bachirstudies-lang/Keep_Tracking/shema electrique/keeptracker_schematic.png

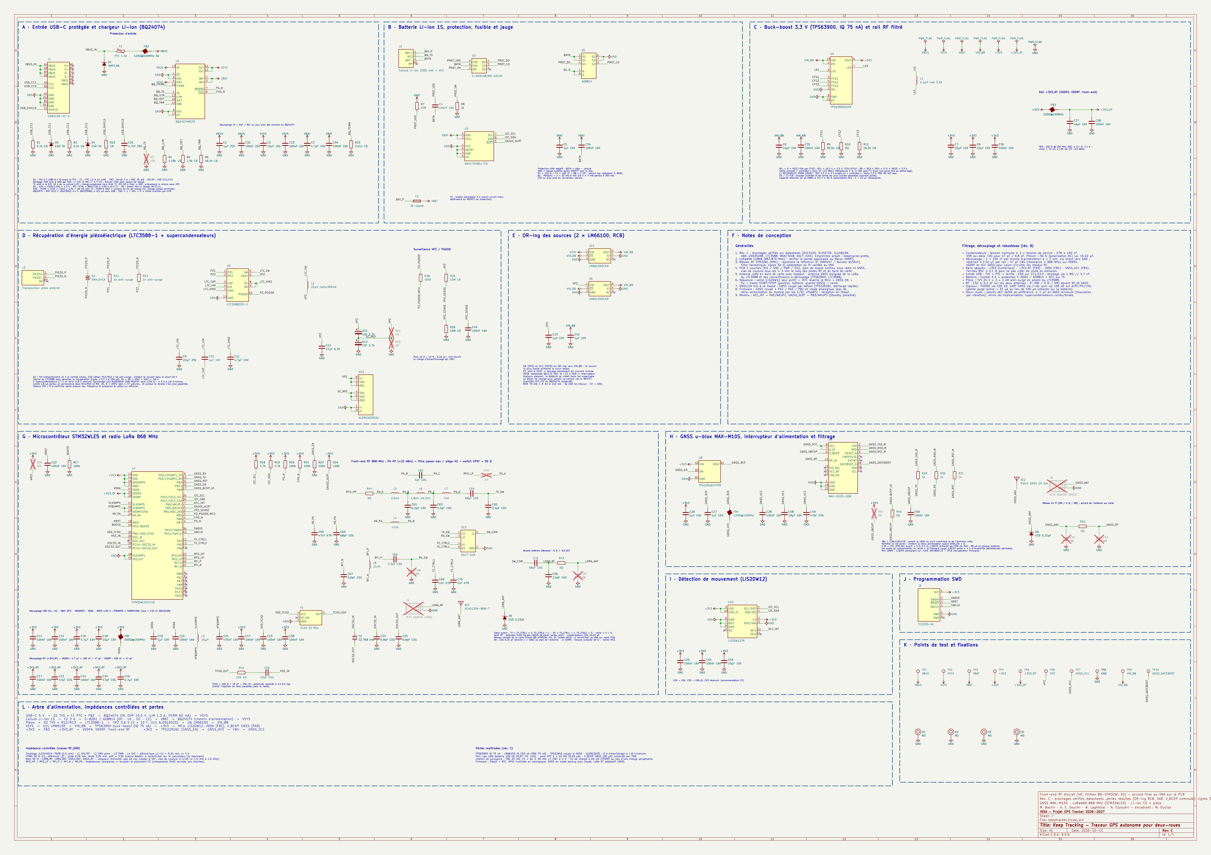
shema electrique/keeptracker_schematic.png
