bachirstudies-lang/Keep_Tracking/shema electrique/rev_B/keeptracker_schematic.png

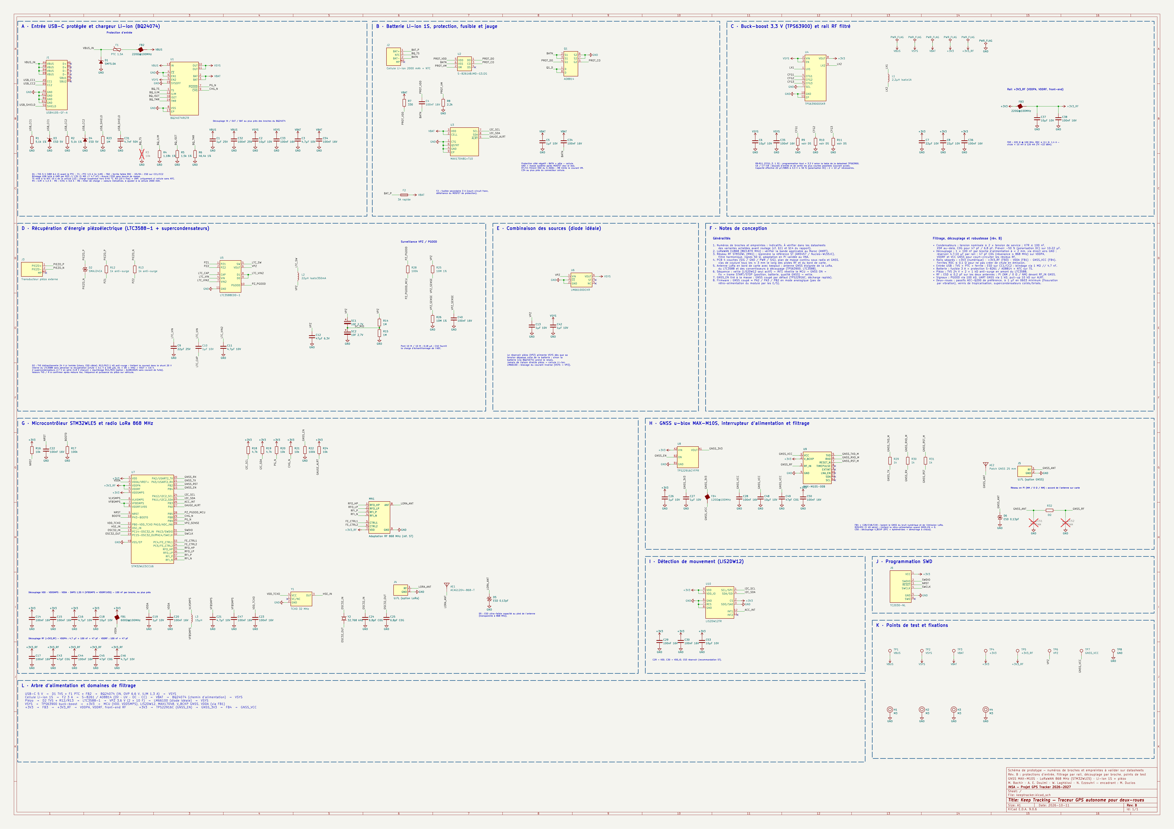
shema electrique/rev_B/keeptracker_schematic.png
