bachirstudies-lang/Keep_Tracking/shema electrique/rev_B/keeptracker_bom.csv

Reference | Value | Footprint | MPN | QUANTITY | DNP
AE1 | ACAG1204-868-T |  |  | 1
AE2 | Patch GNSS 25 mm |  |  | 1
C1 | 1µF 25V | Capacitor_SMD:C_0603_1608Metric |  | 1
C2,C6,C18,C37,C48,C53 | 10µF 10V | Capacitor_SMD:C_0805_2012Metric |  | 6
C3,C11,C16,C21,C46 | 4,7µF 10V | Capacitor_SMD:C_0603_1608Metric |  | 5
C4,C14,C15,C17,C20,C22,C23,C28-C30,C33-C36,C38,C40,C44,C47,C50,C54 | 100nF 16V | Capacitor_SMD:C_0402_1005Metric |  | 20
C5,C13,C19,C26,C27,C42 | 1µF 10V | Capacitor_SMD:C_0402_1005Metric |  | 6
C7,C8 | 22µF 10V | Capacitor_SMD:C_0805_2012Metric |  | 2
C9 | 22µF 25V | Capacitor_SMD:C_1206_3216Metric |  | 1
C10 | 1µF 10V | Capacitor_SMD:C_0603_1608Metric |  | 1
C12 | 47µF 6,3V | Capacitor_SMD:C_1206_3216Metric |  | 1
C24,C25 | 6,8pF C0G | Capacitor_SMD:C_0402_1005Metric |  | 2
C31 | 4,7nF 50V | Capacitor_SMD:C_0402_1005Metric |  | 1
C32 | 100nF 25V | Capacitor_SMD:C_0402_1005Metric |  | 1
C43,C45,C49 | 47pF C0G | Capacitor_SMD:C_0402_1005Metric |  | 3
C51,C52 | NM |  |  | 2 | DNP
D1 | SMF5.0A | Diode_SMD:D_SOD-123F | Littelfuse SMF5.0A | 1
D2 | SMAJ24CA | Diode_SMD:D_SMA | Littelfuse SMAJ24CA | 1
D3,D4 | ESD 5V | Diode_SMD:D_SOD-923 | onsemi ESD9B5.0ST5G | 2
D5,D6 | ESD 0,13pF | Diode_SMD:D_0402_1005Metric | TI TPD1E0B04DPLR | 2
F1 | PTC 1,5A | Fuse:Fuse_1206_3216Metric | Bourns MF-MSMF150-2 | 1
F2 | 3A rapide | Fuse:Fuse_0603_1608Metric | Littelfuse 0467003.NR | 1
FB1 | 600Ω@100MHz | Inductor_SMD:L_0603_1608Metric | Murata BLM18KG601SN1D | 1
FB2,FB3 | 220Ω@100MHz | Inductor_SMD:L_0603_1608Metric | Murata BLM18PG221SN1D | 2
FB4 | 120Ω@100MHz | Inductor_SMD:L_0402_1005Metric | Murata BLM15PX121SN1D | 1
H1-H4 | M3 | MountingHole:MountingHole_3.2mm_M3_Pad_Via |  | 4
J1 | USB4105-GF-A | Connector_USB:USB_C_Receptacle_GCT_USB4105-xx-A_16P_TopMnt_Horizontal | GCT USB4105-GF-A | 1
J2 | Cellule Li-ion 2000 mAh + NTC | Connector_JST:JST_PH_S3B-PH-SM4-TB_1x03-1MP_P2.00mm_Horizontal | JST S3B-PH-SM4-TB | 1
J3 | Transducteur piézo externe | Connector_JST:JST_ZH_B2B-ZR-SM4-TF_1x02-1MP_P1.50mm_Vertical | JST B2B-ZR-SM4-TF | 1
J4 | U.FL (option LoRa) | Connector_Coaxial:U.FL_Hirose_U.FL-R-SMT-1_Vertical |  | 1
J5 | U.FL (option GNSS) | Connector_Coaxial:U.FL_Hirose_U.FL-R-SMT-1_Vertical |  | 1
J6 | TC2030-NL | Connector:Tag-Connect_TC2030-IDC-NL_2x03_P1.27mm_Vertical |  | 1
L1 | 2,2µH Isat≥1A | Inductor_SMD:L_1210_3225Metric | Murata DFE252012F-2R2M | 1
L2 | 22µH Isat≥350mA | Inductor_SMD:L_1210_3225Metric | Murata LQH32PH220MN0 | 1
L3 | 15µH | Inductor_SMD:L_0805_2012Metric | Murata LQM21PN150MC0 | 1
MN1 | Adaptation RF 868 MHz (réf. ST) |  |  | 1
Q1 | AO8814 | Package_SO:TSSOP-8_4.4x3mm_P0.65mm | AOS AO8814 | 1
R1,R2 | 5,1k 1% | Resistor_SMD:R_0603_1608Metric |  | 2
R3 | 10k | Resistor_SMD:R_0603_1608Metric |  | 1 | DNP
R4 | 1,18k 1% | Resistor_SMD:R_0603_1608Metric |  | 1
R5 | 1,5k 1% | Resistor_SMD:R_0603_1608Metric |  | 1
R6 | 46,4k 1% | Resistor_SMD:R_0603_1608Metric |  | 1
R7 | 330 | Resistor_SMD:R_0603_1608Metric |  | 1
R8 | 2,2k | Resistor_SMD:R_0603_1608Metric |  | 1
R9-R11 | voir DS | Resistor_SMD:R_0402_1005Metric |  | 3
R12,R13 | 1k anti-surge | Resistor_SMD:R_1206_3216Metric | Panasonic ERJ-P08J102V | 2
R14,R15,R23 | 1M | Resistor_SMD:R_0603_1608Metric |  | 3
R16,R20,R21,R24 | 10k | Resistor_SMD:R_0603_1608Metric |  | 4
R17,R22,R28 | 100k | Resistor_SMD:R_0603_1608Metric |  | 3
R18,R19 | 4,7k | Resistor_SMD:R_0603_1608Metric |  | 2
R25,R26 | 10M 1% | Resistor_SMD:R_0603_1608Metric |  | 2
R29-R31 | 1k | Resistor_SMD:R_0402_1005Metric |  | 3
R32 | 0Ω | Resistor_SMD:R_0402_1005Metric |  | 1
SC1,SC2 | 10F 2,7V | Capacitor_THT:CP_Radial_D8.0mm_P3.50mm | Eaton HV0830-2R7106-R | 2
TP1 | VBUS | TestPoint:TestPoint_Pad_D1.5mm |  | 1
TP2 | VSYS | TestPoint:TestPoint_Pad_D1.5mm |  | 1
TP3 | VBAT | TestPoint:TestPoint_Pad_D1.5mm |  | 1
TP4 | +3V3 | TestPoint:TestPoint_Pad_D1.5mm |  | 1
TP5 | +3V3_RF | TestPoint:TestPoint_Pad_D1.5mm |  | 1
TP6 | VPZ | TestPoint:TestPoint_Pad_D1.5mm |  | 1
TP7 | GNSS_VCC | TestPoint:TestPoint_Pad_D1.5mm |  | 1
TP8 | GND | TestPoint:TestPoint_Pad_D1.5mm |  | 1
U1 | BQ24074RGTR | Package_DFN_QFN:VQFN-16-1EP_3x3mm_P0.5mm_EP1.68x1.68mm | TI BQ24074RGTR | 1
U2 | S-8261ABJMD-G3J2G | Package_TO_SOT_SMD:SOT-23-6 | ABLIC S-8261ABJMD-G3J2G | 1
U3 | MAX17048G+T10 | Package_DFN_QFN:TDFN-8-1EP_2x2mm_P0.5mm_EP0.8x1.2mm | Maxim MAX17048G+T10 | 1
U4 | TPS63900DSKR | Package_SON:WSON-10-1EP_2.5x2.5mm_P0.5mm_EP1.2x2mm | TI TPS63900DSKR | 1
U5 | LTC3588EDD-1 | Package_DFN_QFN:DFN-10-1EP_3x3mm_P0.5mm_EP1.65x2.38mm | ADI LTC3588EDD-1 | 1
U6 | LM66100DCKR | Package_TO_SOT_SMD:SOT-363_SC-70-6 | TI LM66100DCKR | 1
U7 | STM32WLE5CCU6 | Package_DFN_QFN:QFN-48-1EP_7x7mm_P0.5mm_EP5.3x5.3mm | ST STM32WLE5CCU6 | 1
U8 | TPS22916CYFPR |  | TI TPS22916CYFPR | 1
U9 | MAX-M10S-00B | RF_GPS:ublox_MAX | u-blox MAX-M10S-00B | 1
U10 | LIS2DW12TR | Package_LGA:LGA-12_2x2mm_P0.5mm | ST LIS2DW12TR | 1
Y1 | TCXO 32 MHz | Oscillator:Oscillator_SMD_SiT_PQFN-4Pin_2.0x1.6mm |  | 1
Y2 | 32,768 kHz | Crystal:Crystal_SMD_3215-2Pin_3.2x1.5mm |  | 1
