bachirstudies-lang/Keep_Tracking/shema electrique/keeptracker.kicad_sch

## KiCad design shema electrique/keeptracker.kicad_sch (2026-10-11)

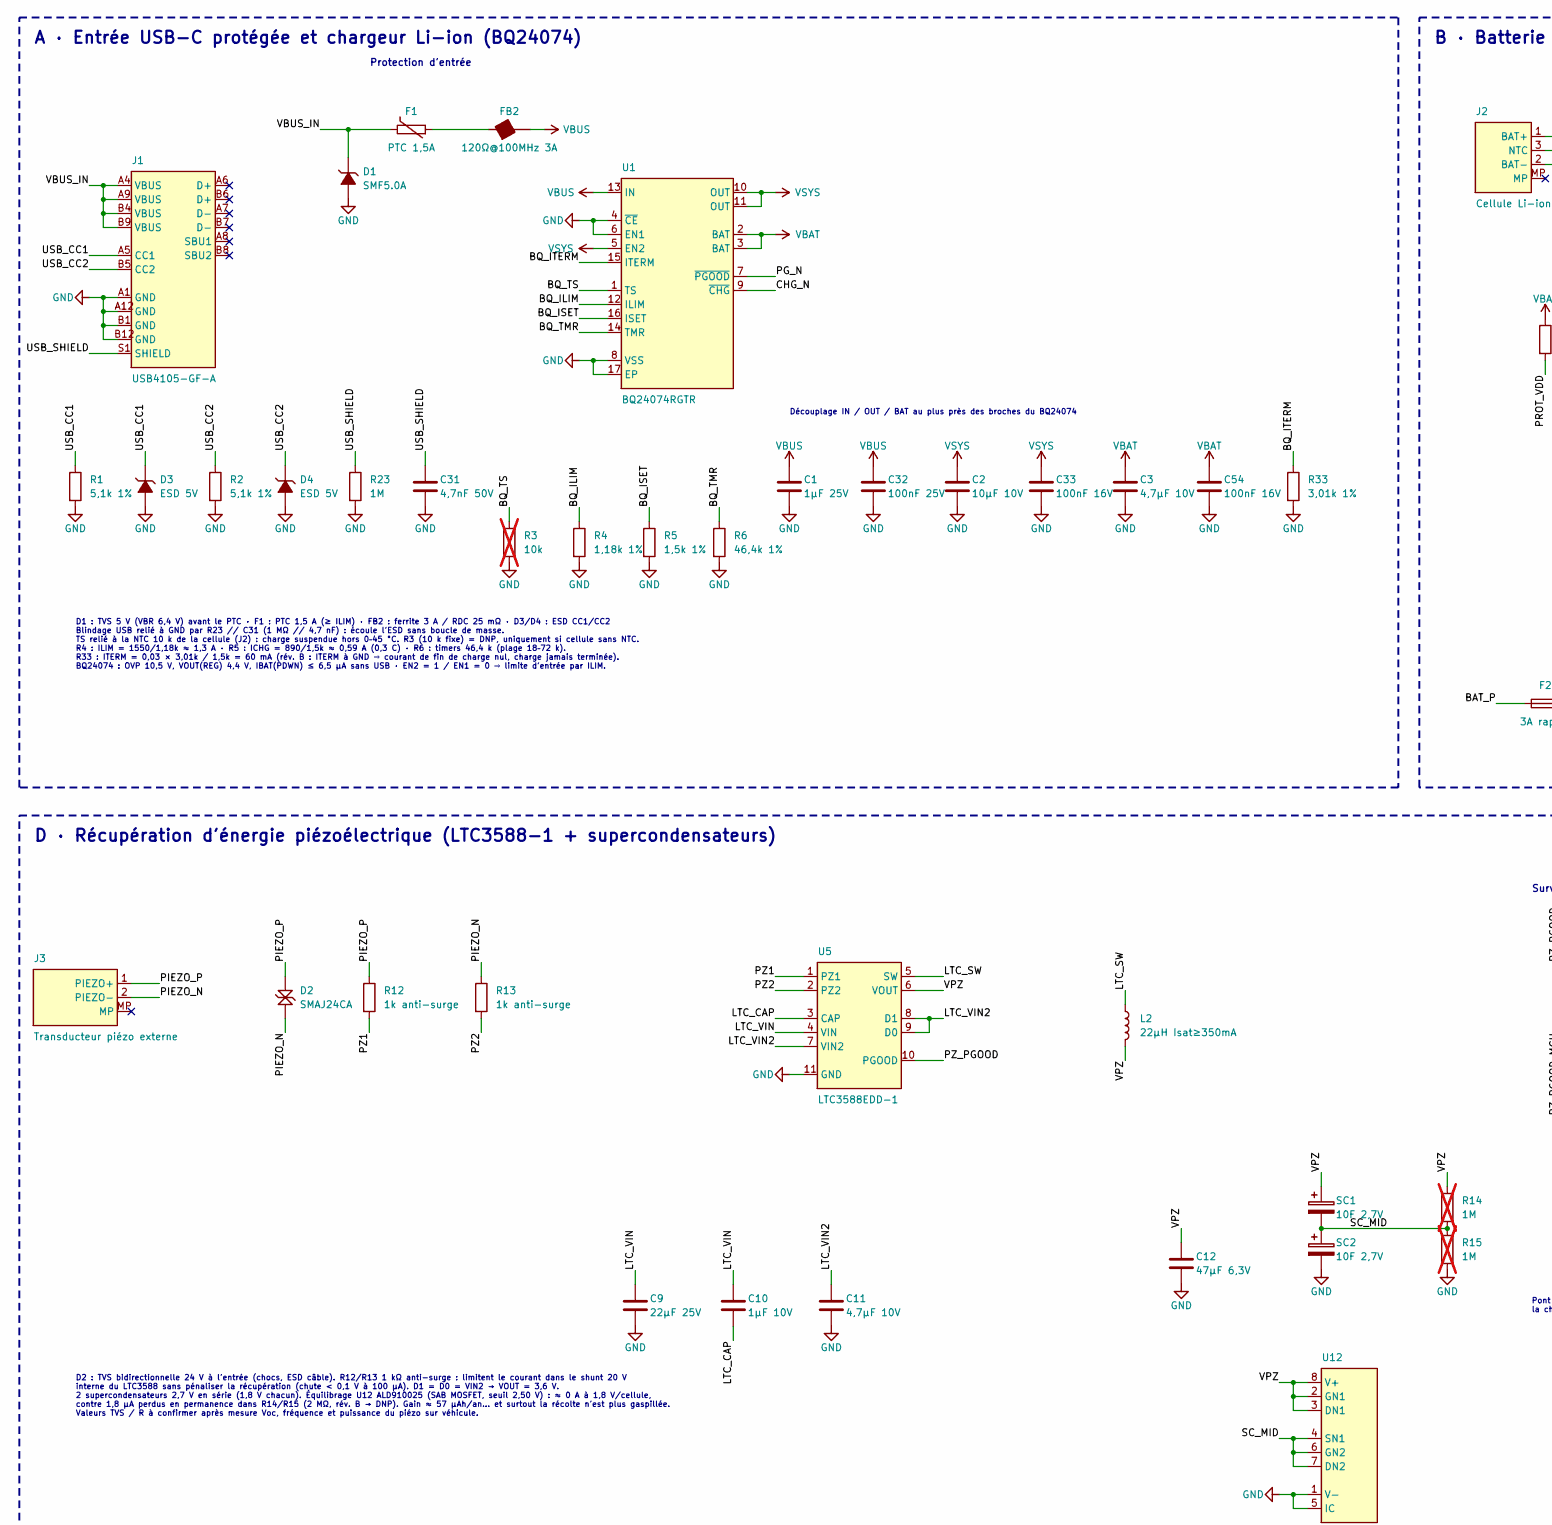
[picture p17: schematic keeptracker.kicad_sch, part in row 1, column 1]

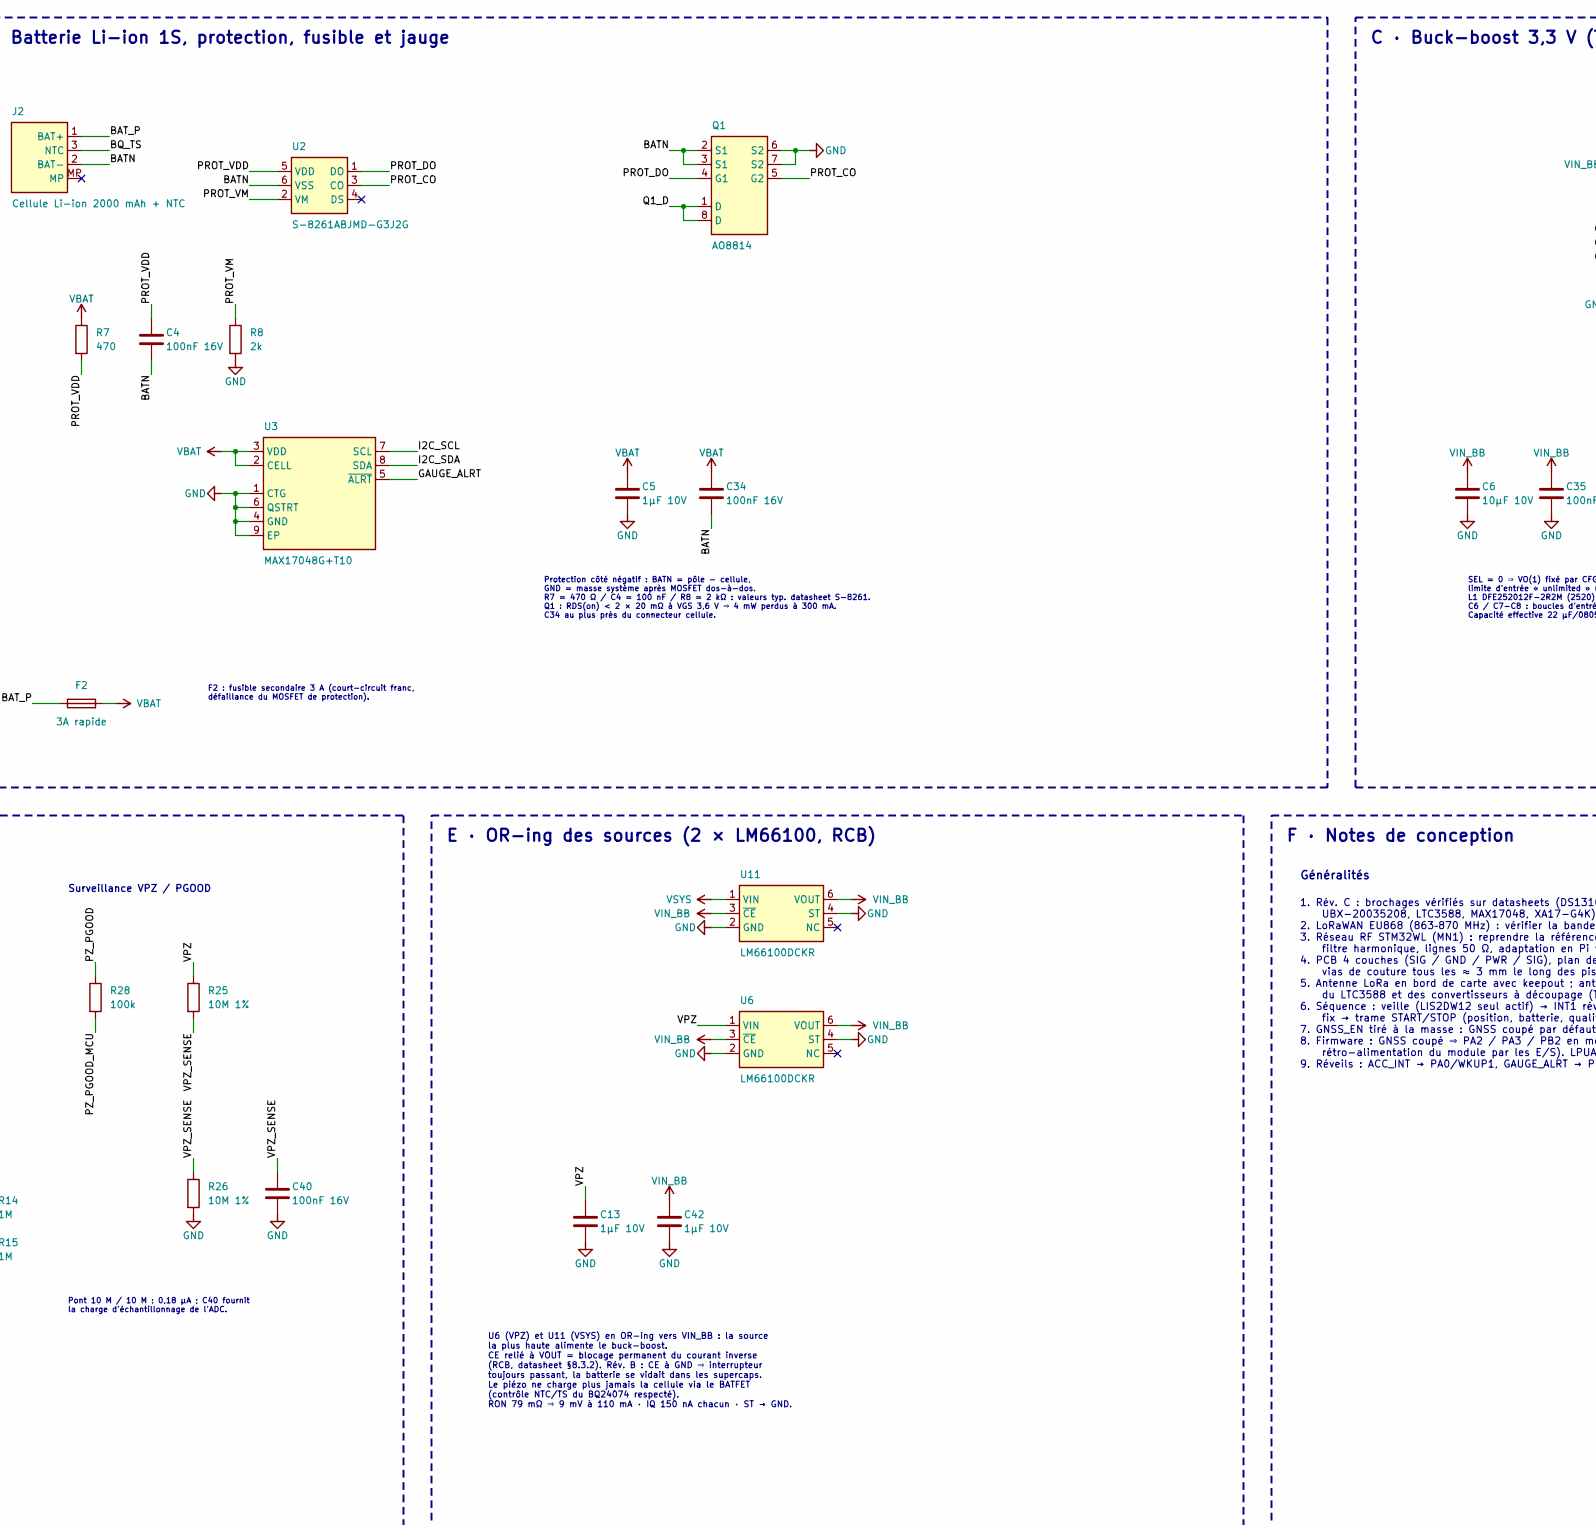
[picture p18: schematic keeptracker.kicad_sch, part in row 1, column 2]

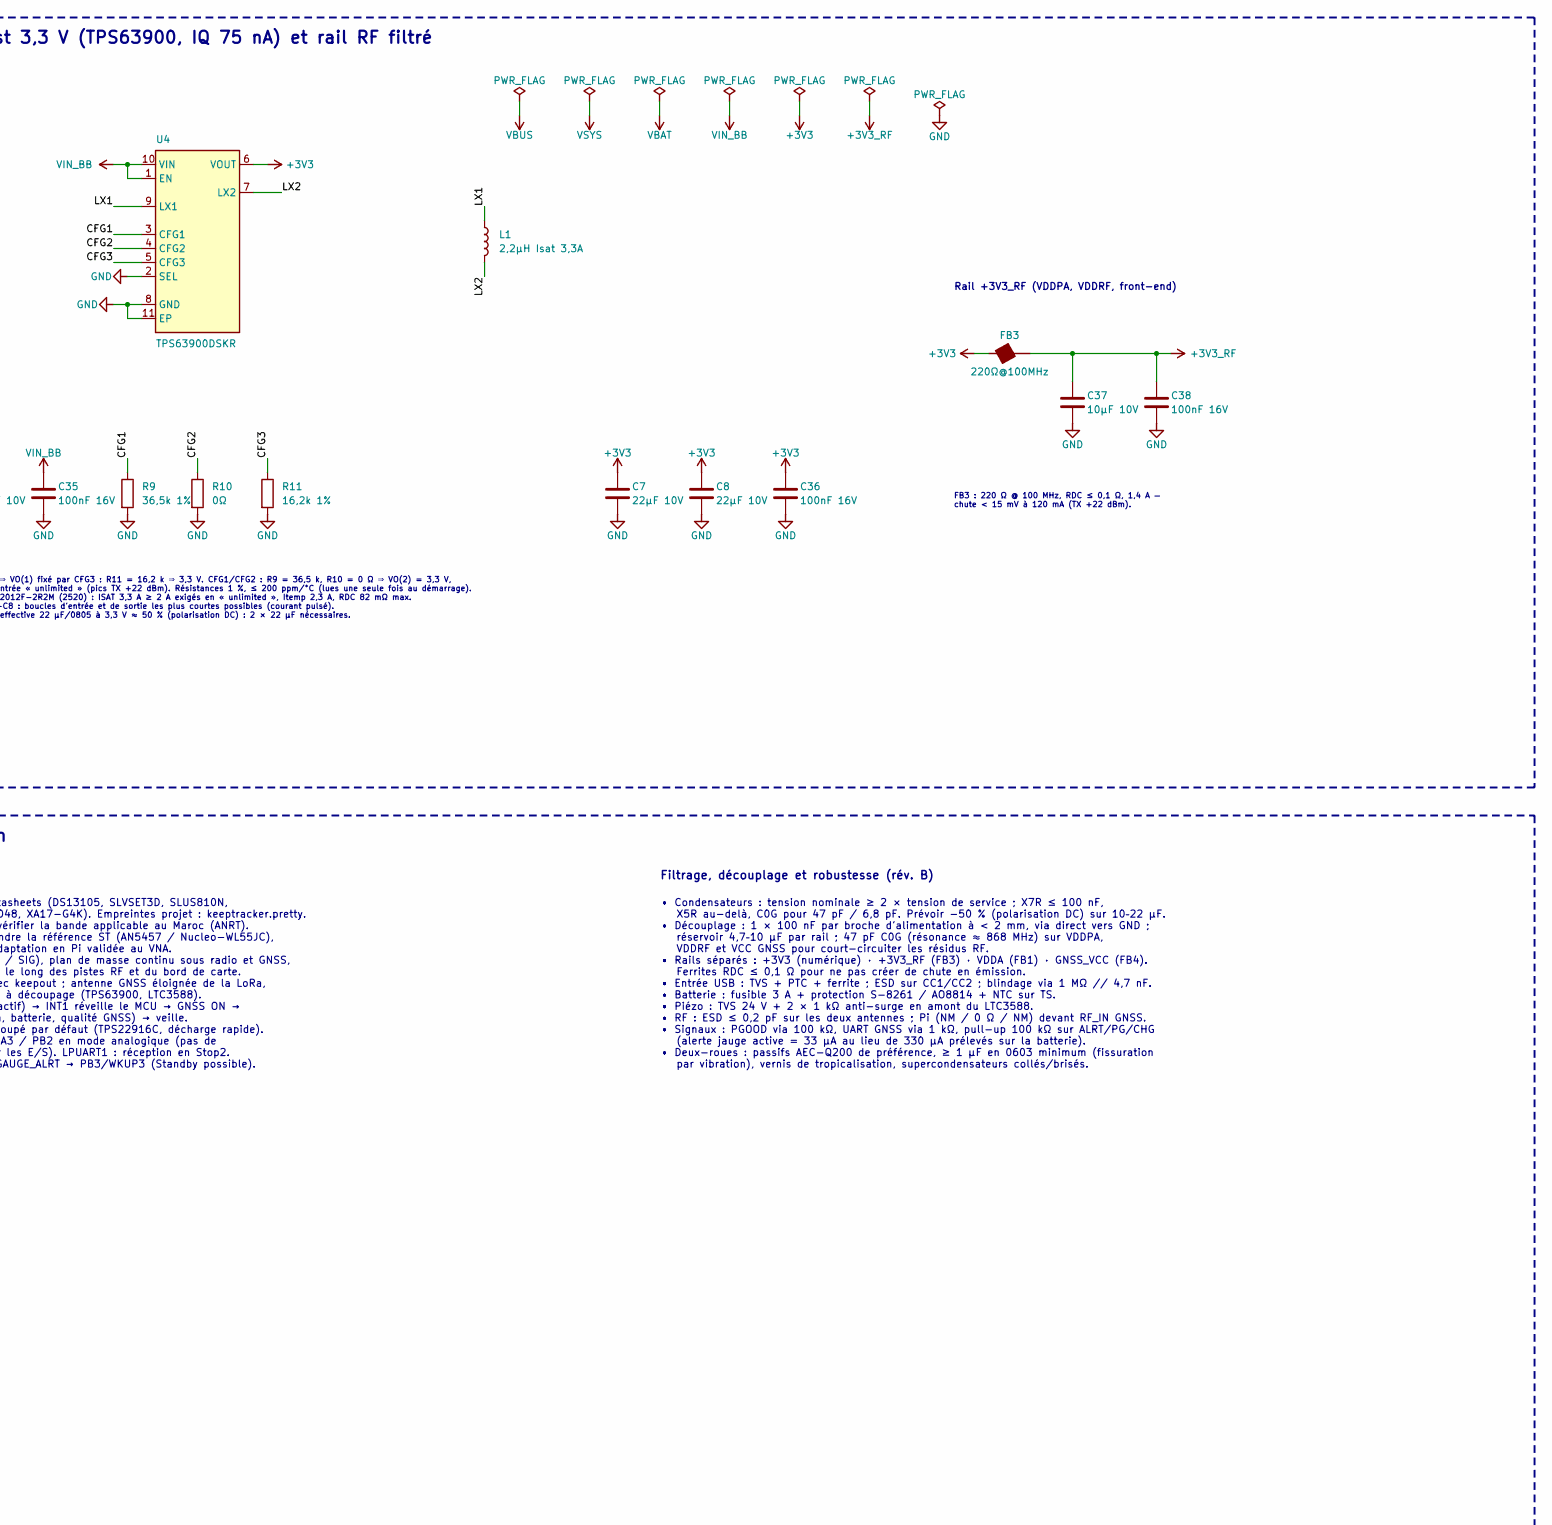
[picture p19: schematic keeptracker.kicad_sch, part in row 1, column 3]

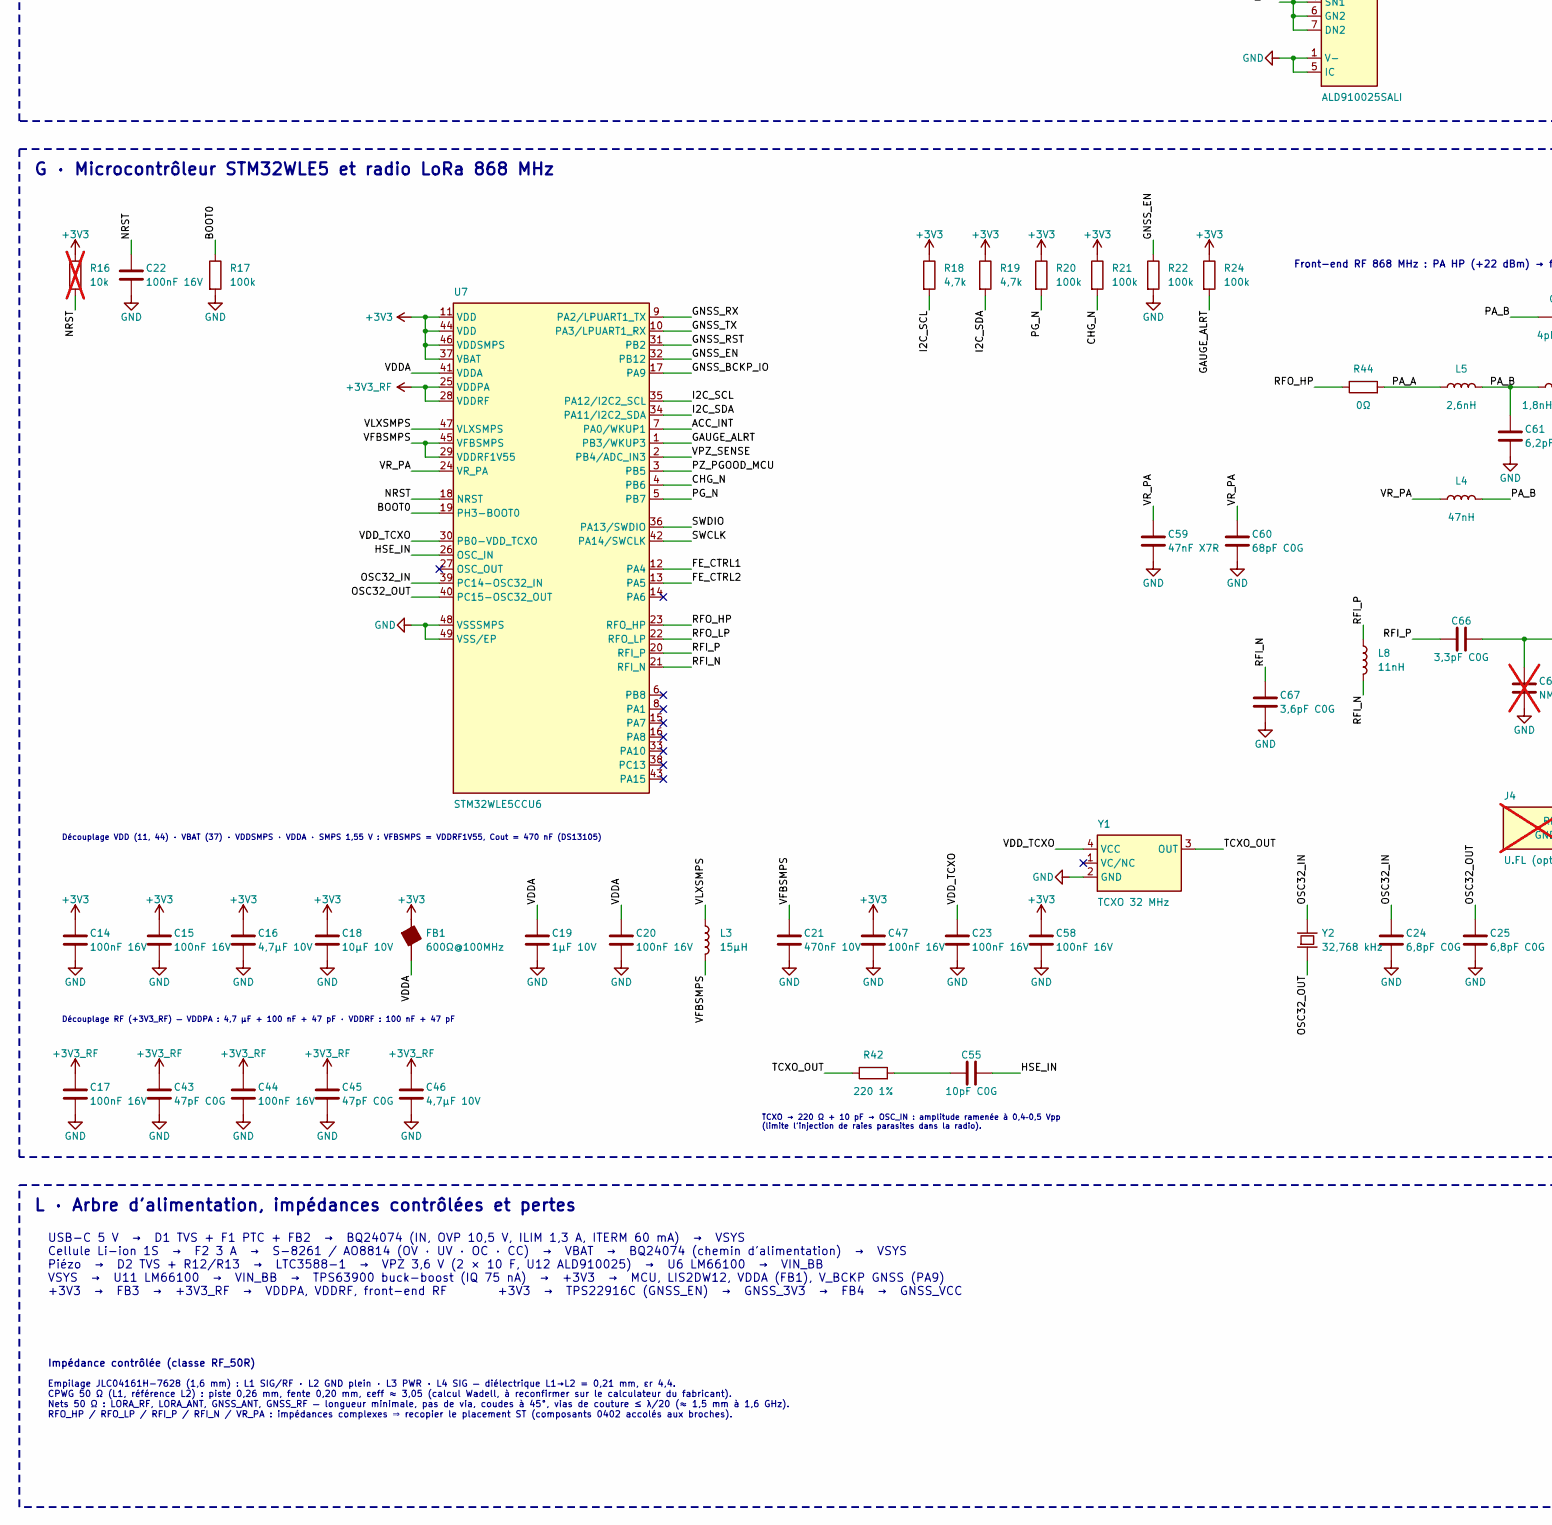
[picture p20: schematic keeptracker.kicad_sch, part in row 2, column 1]

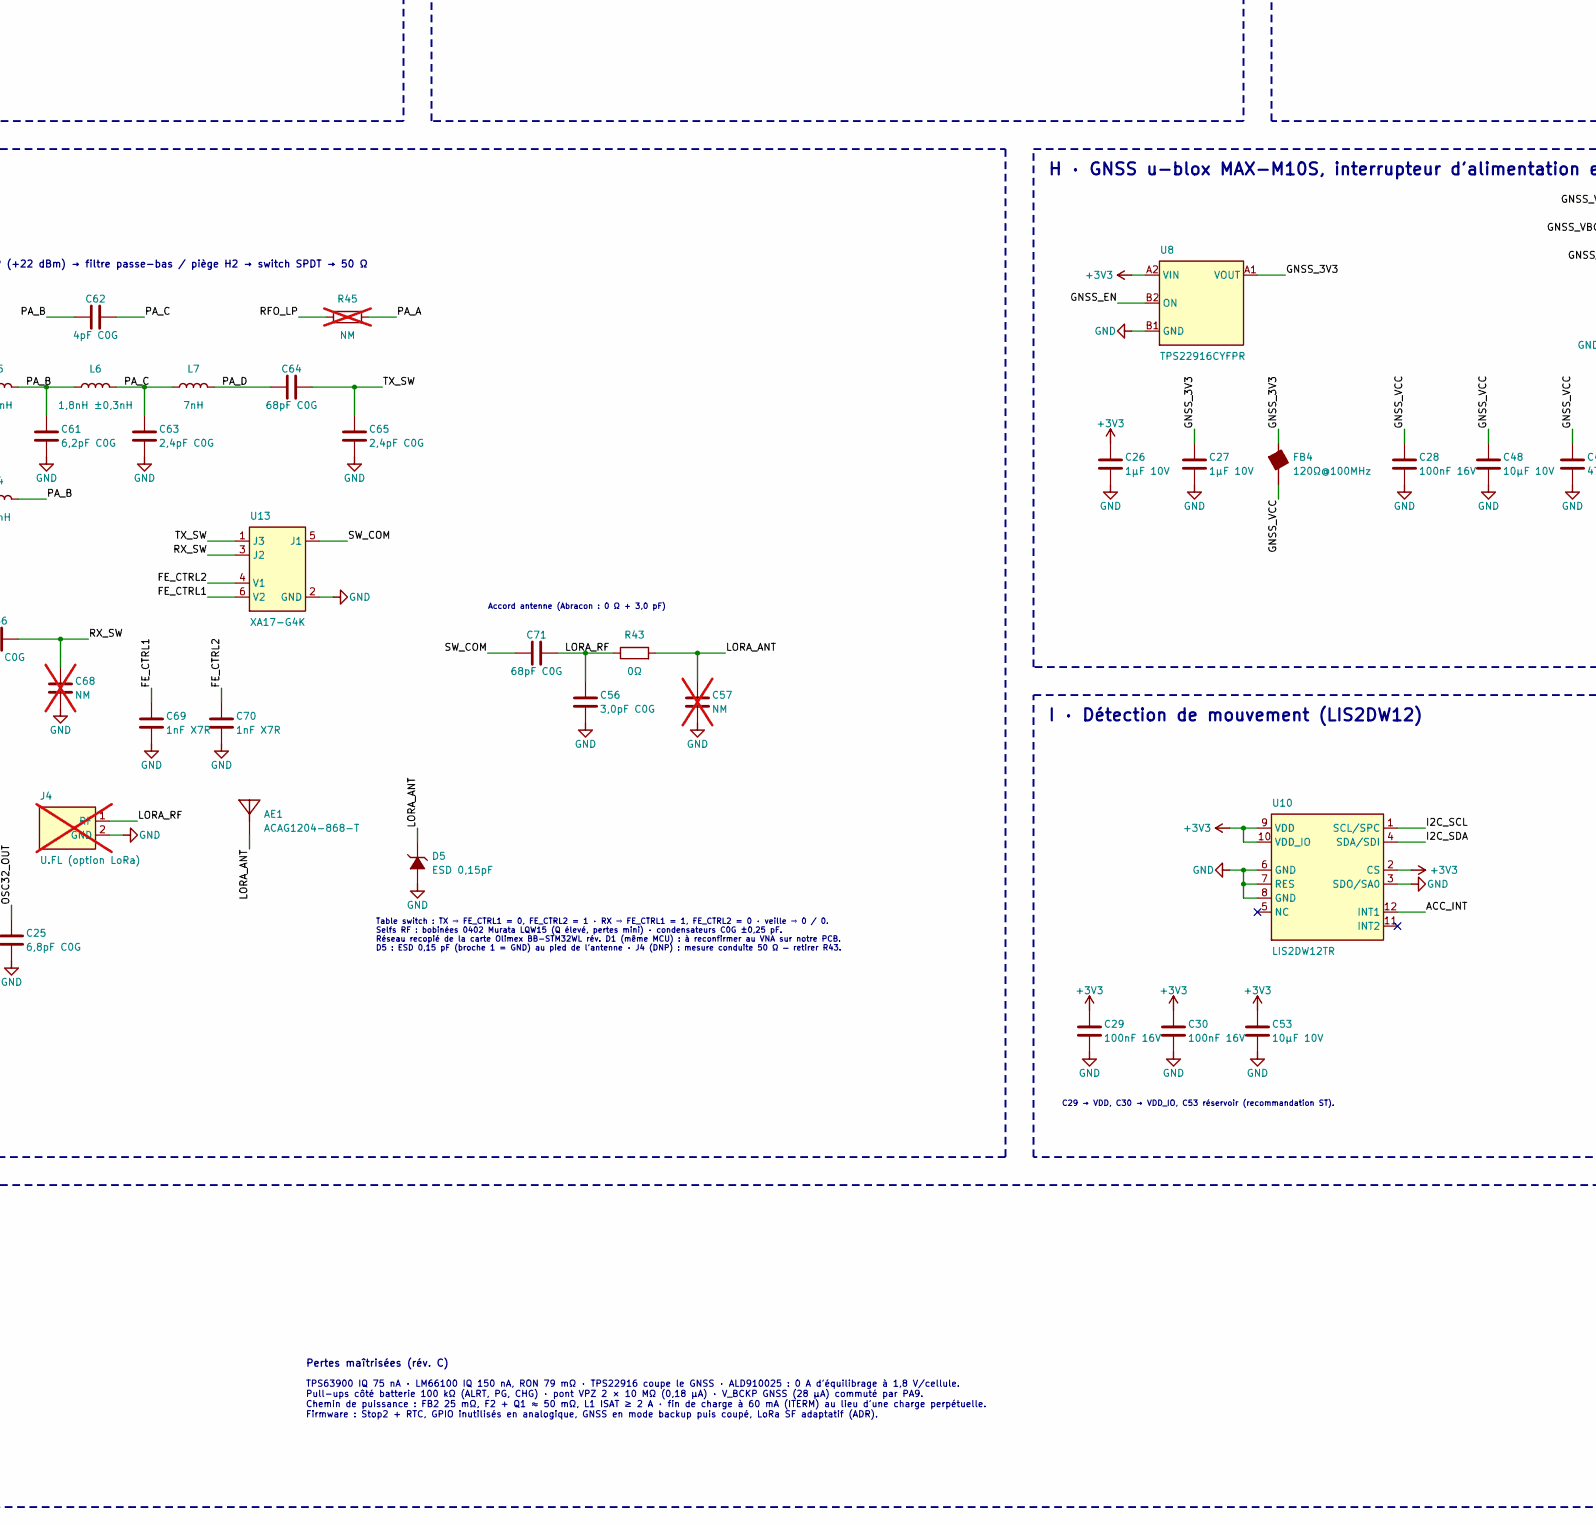
[picture p21: schematic keeptracker.kicad_sch, part in row 2, column 2]

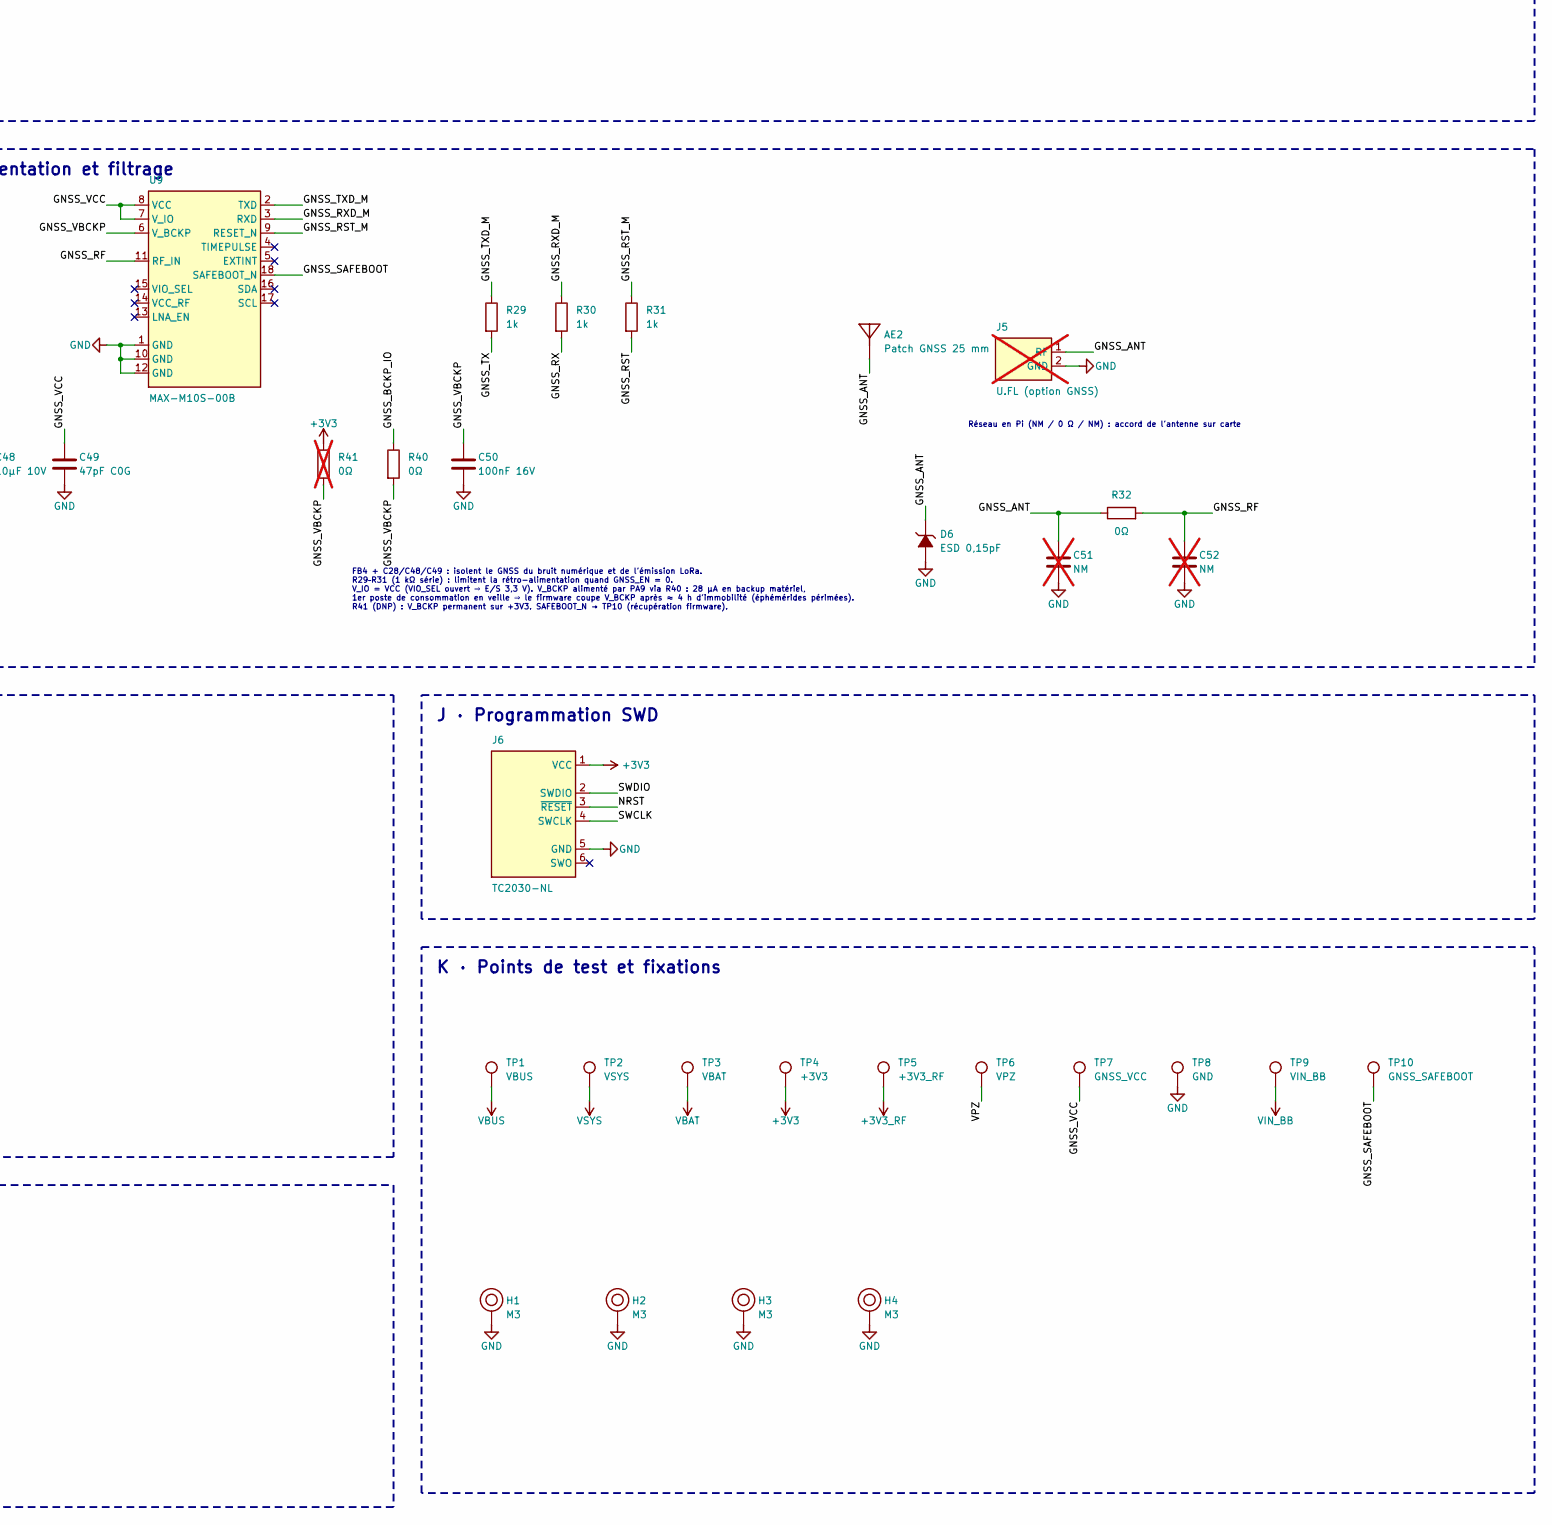
[picture p22: schematic keeptracker.kicad_sch, part in row 2, column 3]

Parts:
AE1: ACAG1204-868-T; Abracon_ACAG1204-868-T; MPN Abracon ACAG1204-868-T
AE2: Patch GNSS 25 mm
C1: 1µF 25V; C_0603_1608Metric
C2, C6, C18, C37, C48, C53: 10µF 10V; C_0805_2012Metric
C3, C11, C16, C46: 4,7µF 10V; C_0603_1608Metric
C4, C14, C15, C17, C20, C22, C23, C28, C29, C30, C33, C34, C35, C36, C38, C40, C44, C47, C50, C54, C58: 100nF 16V; C_0402_1005Metric
C5, C13, C19, C26, C27, C42: 1µF 10V; C_0402_1005Metric
C7, C8: 22µF 10V; C_0805_2012Metric
C9: 22µF 25V; C_1206_3216Metric
C10: 1µF 10V; C_0603_1608Metric
C12: 47µF 6,3V; C_1206_3216Metric
C21: 470nF 10V; C_0402_1005Metric
C24, C25: 6,8pF C0G; C_0402_1005Metric
C31: 4,7nF 50V; C_0402_1005Metric
C32: 100nF 25V; C_0402_1005Metric
C43, C45, C49: 47pF C0G; C_0402_1005Metric
C51, C52, C57: NM; not fitted
C55: 10pF C0G; C_0402_1005Metric
C56: 3,0pF C0G; C_0402_1005Metric; MPN Murata GJM1555C1H3R0CB01
C59: 47nF X7R; C_0402_1005Metric
C60, C64, C71: 68pF C0G; C_0402_1005Metric; MPN Murata GRM1555C1H680JA01
C61: 6,2pF C0G; C_0402_1005Metric; MPN Murata GJM1555C1H6R2DB01
C62: 4pF C0G; C_0402_1005Metric; MPN Murata GJM1555C1H4R0CB01
C63, C65: 2,4pF C0G; C_0402_1005Metric; MPN Murata GJM1555C1H2R4CB01
C66: 3,3pF C0G; C_0402_1005Metric; MPN Murata GJM1555C1H3R3CB01
C67: 3,6pF C0G; C_0402_1005Metric; MPN Murata GJM1555C1H3R6CB01
C68: NM; C_0402_1005Metric; not fitted
C69, C70: 1nF X7R; C_0402_1005Metric
D1: SMF5.0A; D_SOD-123F; MPN Littelfuse SMF5.0A
D2: SMAJ24CA; D_SMA; MPN Littelfuse SMAJ24CA
D3, D4: ESD 5V; D_SOD-923; MPN onsemi ESD9B5.0ST5G
D5, D6: ESD 0,15pF; D_0402_1005Metric; MPN TI TPD1E0B04DPYR
F1: PTC 1,5A; Fuse_1206_3216Metric; MPN Bourns MF-MSMF150-2
F2: 3A rapide; Fuse_0603_1608Metric; MPN Littelfuse 0467003.NR
FB1: 600Ω@100MHz; L_0603_1608Metric; MPN Murata BLM18KG601SN1D
FB2: 120Ω@100MHz 3A; L_0603_1608Metric; MPN Murata BLM18SG121TN1D
FB3: 220Ω@100MHz; L_0603_1608Metric; MPN Murata BLM18PG221SN1D
FB4: 120Ω@100MHz; L_0402_1005Metric; MPN Murata BLM15PX121SN1D
H1, H2, H3, H4: M3; MountingHole_3.2mm_M3_Pad_Via
J1: USB4105-GF-A; USB_C_Receptacle_GCT_USB4105-xx-A_16P_TopMnt_Horizontal; MPN GCT USB4105-GF-A
J2: Cellule Li-ion 2000 mAh + NTC; JST_PH_S3B-PH-SM4-TB_1x03-1MP_P2.00mm_Horizontal; MPN JST S3B-PH-SM4-TB
J3: Transducteur piézo externe; JST_ZH_B2B-ZR-SM4-TF_1x02-1MP_P1.50mm_Vertical; MPN JST B2B-ZR-SM4-TF
J4: U.FL (option LoRa); U.FL_Hirose_U.FL-R-SMT-1_Vertical; not fitted
J5: U.FL (option GNSS); U.FL_Hirose_U.FL-R-SMT-1_Vertical; not fitted
J6: TC2030-NL; Tag-Connect_TC2030-IDC-NL_2x03_P1.27mm_Vertical
L1: 2,2µH Isat 3,3A; L_1008_2520Metric; MPN Murata DFE252012F-2R2M
L2: 22µH Isat≥350mA; L_1210_3225Metric; MPN Murata LQH32PH220MN0
L3: 15µH; L_0805_2012Metric; MPN Murata LQM21PN150MC0
L4: 47nH; L_0402_1005Metric; MPN Murata LQW15AN47NG00
L5: 2,6nH; L_0402_1005Metric; MPN Murata LQW15AN2N6B00
L6: 1,8nH ±0,3nH; L_0402_1005Metric; MPN Murata LQG15HS1N8S02D
L7: 7nH; L_0402_1005Metric; MPN Murata LQW15AN7N0G00
L8: 11nH; L_0402_1005Metric; MPN Murata LQW15AN11NG00
Q1: AO8814; TSSOP-8_4.4x3mm_P0.65mm; MPN AOS AO8814
R1, R2: 5,1k 1%; R_0603_1608Metric
R3, R16: 10k; R_0603_1608Metric; not fitted
R4: 1,18k 1%; R_0603_1608Metric
R5: 1,5k 1%; R_0603_1608Metric
R6: 46,4k 1%; R_0603_1608Metric
R7: 470; R_0603_1608Metric
R8: 2k; R_0603_1608Metric
R9: 36,5k 1%; R_0402_1005Metric
R10, R32, R40, R43, R44: 0Ω; R_0402_1005Metric
R11: 16,2k 1%; R_0402_1005Metric
R12, R13: 1k anti-surge; R_1206_3216Metric; MPN Panasonic ERJ-P08J102V
R14, R15: 1M; R_0603_1608Metric; not fitted
R17, R20, R21, R22, R24, R28: 100k; R_0603_1608Metric
R18, R19: 4,7k; R_0603_1608Metric
R23: 1M; R_0603_1608Metric
R25, R26: 10M 1%; R_0603_1608Metric
R29, R30, R31: 1k; R_0402_1005Metric
R33: 3,01k 1%; R_0603_1608Metric
R41: 0Ω; R_0402_1005Metric; not fitted
R42: 220 1%; R_0402_1005Metric
R45: NM; R_0402_1005Metric; not fitted
SC1, SC2: 10F 2,7V; CP_Radial_D8.0mm_P3.50mm; MPN Eaton HV0830-2R7106-R
TP1: VBUS; TestPoint_Pad_D1.5mm
TP2: VSYS; TestPoint_Pad_D1.5mm
TP3: VBAT; TestPoint_Pad_D1.5mm
TP4: +3V3; TestPoint_Pad_D1.5mm
TP5: +3V3_RF; TestPoint_Pad_D1.5mm
TP6: VPZ; TestPoint_Pad_D1.5mm
TP7: GNSS_VCC; TestPoint_Pad_D1.5mm
TP8: GND; TestPoint_Pad_D1.5mm
TP9: VIN_BB; TestPoint_Pad_D1.5mm
TP10: GNSS_SAFEBOOT; TestPoint_Pad_D1.5mm
U1: BQ24074RGTR; VQFN-16-1EP_3x3mm_P0.5mm_EP1.68x1.68mm; MPN TI BQ24074RGTR
U2: S-8261ABJMD-G3J2G; SOT-23-6; MPN ABLIC S-8261ABJMD-G3J2G
U3: MAX17048G+T10; TDFN-8-1EP_2x2mm_P0.5mm_EP0.8x1.2mm; MPN Maxim MAX17048G+T10
U4: TPS63900DSKR; WSON-10-1EP_2.5x2.5mm_P0.5mm_EP1.2x2mm; MPN TI TPS63900DSKR
U5: LTC3588EDD-1; DFN-10-1EP_3x3mm_P0.5mm_EP1.65x2.38mm; MPN ADI LTC3588EDD-1
U6, U11: LM66100DCKR; SOT-363_SC-70-6; MPN TI LM66100DCKR
U7: STM32WLE5CCU6; QFN-48-1EP_7x7mm_P0.5mm_EP5.3x5.3mm; MPN ST STM32WLE5CCU6
U8: TPS22916CYFPR; TI_DSBGA-4_YFP_0.78x0.78mm_P0.4mm; MPN TI TPS22916CYFPR
U9: MAX-M10S-00B; ublox_MAX; MPN u-blox MAX-M10S-00B
U10: LIS2DW12TR; LGA-12_2x2mm_P0.5mm; MPN ST LIS2DW12TR
U12: ALD910025SALI; SOIC-8_3.9x4.9mm_P1.27mm; MPN ALD910025SALI
U13: XA17-G4K; SOT-363_SC-70-6; MPN Xinluda XA17-G4K (LCSC C513494)
Y1: TCXO 32 MHz; Oscillator_SMD_SiT_PQFN-4Pin_2.0x1.6mm
Y2: 32,768 kHz; Crystal_SMD_3215-2Pin_3.2x1.5mm

Connections:
+3V3: C7.1, C8.1, C14.1, C15.1, C16.1, C18.1, C26.1, C29.1, C30.1, C36.1, C47.1, C53.1, C58.1, FB1.1, FB3.1, J6.1 (VCC), R16.1, R18.1, R19.1, R20.1, R21.1, R24.1, R41.1, TP4.1, U4.6 (VOUT), U7.11 (VDD), U7.37 (VBAT), U7.44 (VDD), U7.46 (VDDSMPS), U8.A2 (VIN), U10.2 (CS), U10.9 (VDD), U10.10 (VDD_IO)
+3V3_RF: C17.1, C37.1, C38.1, C43.1, C44.1, C45.1, C46.1, FB3.2, TP5.1, U7.25 (VDDPA), U7.28 (VDDRF)
ACC_INT: U7.7 (PA0/WKUP1), U10.12 (INT1)
BATN: C4.2, C34.2, J2.2 (BAT-), Q1.2 (S1), Q1.3 (S1), U2.6 (VSS)
BAT_P: F2.1, J2.1 (BAT+)
BOOT0: R17.1, U7.19 (PH3-BOOT0)
BQ_ILIM: R4.1, U1.12 (ILIM)
BQ_ISET: R5.1, U1.16 (ISET)
BQ_ITERM: R33.1, U1.15 (ITERM)
BQ_TMR: R6.1, U1.14 (TMR)
BQ_TS: J2.3 (NTC), R3.1, U1.1 (TS)
CFG1: R9.1, U4.3 (CFG1)
CFG2: R10.1, U4.4 (CFG2)
CFG3: R11.1, U4.5 (CFG3)
CHG_N: R21.2, U1.9 (~CHG), U7.4 (PB6)
FE_CTRL1: C69.1, U7.12 (PA4), U13.6 (V2)
FE_CTRL2: C70.1, U7.13 (PA5), U13.4 (V1)
GAUGE_ALRT: R24.2, U3.5 (~ALRT), U7.1 (PB3/WKUP3)
GND: C1.2, C2.2, C3.2, C5.2, C6.2, C7.2, C8.2, C9.2, C11.2, C12.2, C13.2, C14.2, C15.2, C16.2, C17.2, C18.2, C19.2, C20.2, C21.2, C22.2, C23.2, C24.2, C25.2, C26.2, C27.2, C28.2, C29.2, C30.2, C31.2, C32.2, C33.2, C35.2, C36.2, C37.2, C38.2, C40.2, C42.2, C43.2, C44.2, C45.2, C46.2, C47.2, C48.2, C49.2, C50.2, C51.2, C52.2, C53.2, C54.2, C56.2, C57.2, C58.2, C59.2, C60.2, C61.2, C63.2, C65.2, C67.2, C68.2, C69.2, C70.2, D1.2, D3.2, D4.2, D5.1 (GND), D6.1 (GND), H1.1, H2.1, H3.1, H4.1, J1.A1 (GND), J1.A12 (GND), J1.B1 (GND), J1.B12 (GND), J4.2 (GND), J5.2 (GND), J6.5 (GND), Q1.6 (S2), Q1.7 (S2), R1.2, R2.2, R3.2, R4.2, R5.2, R6.2, R8.2, R9.2, R10.2, R11.2, R15.2, R17.2, R22.2, R23.2, R26.2, R33.2, SC2.2, TP8.1, U1.4 (~CE), U1.6 (EN1), U1.8 (VSS), U1.17 (EP), U3.1 (CTG), U3.4 (GND), U3.6 (QSTRT), U3.9 (EP), U4.2 (SEL), U4.8 (GND), U4.11 (EP), U5.11 (GND), U6.2 (GND), U6.4 (ST), U7.48 (VSSSMPS), U7.49 (VSS/EP), U8.B1 (GND), U9.1 (GND), U9.10 (GND), U9.12 (GND), U10.3 (SDO/SA0), U10.6 (GND), U10.7 (RES), U10.8 (GND), U11.2 (GND), U11.4 (ST), U12.1 (V-), U12.5 (IC), U13.2 (GND), Y1.2 (GND)
GNSS_3V3: C27.1, FB4.1, U8.A1 (VOUT)
GNSS_ANT: AE2.1, C51.1, D6.2 (IO), J5.1 (RF), R32.1
GNSS_BCKP_IO: R40.1, U7.17 (PA9)
GNSS_EN: R22.1, U7.32 (PB12), U8.B2 (ON)
GNSS_RF: C52.1, R32.2, U9.11 (RF_IN)
GNSS_RST: R31.2, U7.31 (PB2)
GNSS_RST_M: R31.1, U9.9 (RESET_N)
GNSS_RX: R30.2, U7.9 (PA2/LPUART1_TX)
GNSS_RXD_M: R30.1, U9.3 (RXD)
GNSS_SAFEBOOT: TP10.1, U9.18 (SAFEBOOT_N)
GNSS_TX: R29.2, U7.10 (PA3/LPUART1_RX)
GNSS_TXD_M: R29.1, U9.2 (TXD)
GNSS_VBCKP: C50.1, R40.2, R41.2, U9.6 (V_BCKP)
GNSS_VCC: C28.1, C48.1, C49.1, FB4.2, TP7.1, U9.7 (V_IO), U9.8 (VCC)
HSE_IN: C55.2, U7.26 (OSC_IN)
I2C_SCL: R18.2, U3.7 (SCL), U7.35 (PA12/I2C2_SCL), U10.1 (SCL/SPC)
I2C_SDA: R19.2, U3.8 (SDA), U7.34 (PA11/I2C2_SDA), U10.4 (SDA/SDI)
LORA_ANT: AE1.1, C57.1, D5.2 (IO), R43.2
LORA_RF: C56.1, C71.2, J4.1 (RF), R43.1
LTC_CAP: C10.2, U5.3 (CAP)
LTC_SW: L2.1, U5.5 (SW)
LTC_VIN: C9.1, C10.1, U5.4 (VIN)
LTC_VIN2: C11.1, U5.7 (VIN2), U5.8 (D1), U5.9 (D0)
LX1: L1.1, U4.9 (LX1)
LX2: L1.2, U4.7 (LX2)
NRST: C22.1, J6.3 (~RESET), R16.2, U7.18 (NRST)
unnamed: C55.1, R42.2
unnamed: F1.2, FB2.1
OSC32_IN: C24.1, U7.39 (PC14-OSC32_IN), Y2.1
OSC32_OUT: C25.1, U7.40 (PC15-OSC32_OUT), Y2.2
PA_A: L5.1, R44.2, R45.2
PA_B: C61.1, C62.1, L4.2, L5.2, L6.1
PA_C: C62.2, C63.1, L6.2, L7.1
PA_D: C64.1, L7.2
PG_N: R20.2, U1.7 (~PGOOD), U7.5 (PB7)
PIEZO_N: D2.2, J3.2 (PIEZO-), R13.1
PIEZO_P: D2.1, J3.1 (PIEZO+), R12.1
PROT_CO: Q1.5 (G2), U2.3 (CO)
PROT_DO: Q1.4 (G1), U2.1 (DO)
PROT_VDD: C4.1, R7.2, U2.5 (VDD)
PROT_VM: R8.1, U2.2 (VM)
PZ1: R12.2, U5.1 (PZ1)
PZ2: R13.2, U5.2 (PZ2)
PZ_PGOOD: R28.1, U5.10 (PGOOD)
PZ_PGOOD_MCU: R28.2, U7.3 (PB5)
Q1_D: Q1.1 (D), Q1.8 (D)
RFI_N: C67.1, L8.2, U7.21 (RFI_N)
RFI_P: C66.1, L8.1, U7.20 (RFI_P)
RFO_HP: R44.1, U7.23 (RFO_HP)
RFO_LP: R45.1, U7.22 (RFO_LP)
RX_SW: C66.2, C68.1, U13.3 (J2)
SC_MID: R14.2, R15.1, SC1.2, SC2.1, U12.4 (SN1), U12.6 (GN2), U12.7 (DN2)
SWCLK: J6.4 (SWCLK), U7.42 (PA14/SWCLK)
SWDIO: J6.2 (SWDIO), U7.36 (PA13/SWDIO)
SW_COM: C71.1, U13.5 (J1)
TCXO_OUT: R42.1, Y1.3 (OUT)
TX_SW: C64.2, C65.1, U13.1 (J3)
USB_CC1: D3.1, J1.A5 (CC1), R1.1
USB_CC2: D4.1, J1.B5 (CC2), R2.1
USB_SHIELD: C31.1, J1.S1 (SHIELD), R23.1
VBAT: C3.1, C5.1, C34.1, C54.1, F2.2, R7.1, TP3.1, U1.2 (BAT), U1.3 (BAT), U3.2 (CELL), U3.3 (VDD)
VBUS: C1.1, C32.1, FB2.2, TP1.1, U1.13 (IN)
VBUS_IN: D1.1, F1.1, J1.A4 (VBUS), J1.A9 (VBUS), J1.B4 (VBUS), J1.B9 (VBUS)
VDDA: C19.1, C20.1, FB1.2, U7.41 (VDDA)
VDD_TCXO: C23.1, U7.30 (PB0-VDD_TCXO), Y1.4 (VCC)
VFBSMPS: C21.1, L3.2, U7.29 (VDDRF1V55), U7.45 (VFBSMPS)
VIN_BB: C6.1, C35.1, C42.1, TP9.1, U4.1 (EN), U4.10 (VIN), U6.3 (~CE), U6.6 (VOUT), U11.3 (~CE), U11.6 (VOUT)
VLXSMPS: L3.1, U7.47 (VLXSMPS)
VPZ: C12.1, C13.1, L2.2, R14.1, R25.1, SC1.1, TP6.1, U5.6 (VOUT), U6.1 (VIN), U12.2 (GN1), U12.3 (DN1), U12.8 (V+)
VPZ_SENSE: C40.1, R25.2, R26.1, U7.2 (PB4/ADC_IN3)
VR_PA: C59.1, C60.1, L4.1, U7.24 (VR_PA)
VSYS: C2.1, C33.1, TP2.1, U1.5 (EN2), U1.10 (OUT), U1.11 (OUT), U11.1 (VIN)

Notes on the sheet:
A · Entrée USB-C protégée et chargeur Li-ion (BQ24074)
Protection d'entrée
Découplage IN / OUT / BAT au plus près des broches du BQ24074
D1 : TVS 5 V (VBR 6,4 V) avant le PTC · F1 : PTC 1,5 A (≥ ILIM) · FB2 : ferrite 3 A / RDC 25 mΩ · D3/D4 : ESD CC1/CC2 Blindage USB relié à GND par R23 // C31 (1 MΩ // 4,7 nF) : écoule l'ESD sans boucle de masse. TS relié à la NTC 10 k de la cellule (J2) : charge suspendue hors 0–45 °C. R3 (10 k fix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
B · Batterie Li-ion 1S, protection, fusible et jauge
F2 : fusible secondaire 3 A (court-circuit franc, défaillance du MOSFET de protection).
Protection côté négatif : BATN = pôle − cellule, GND = masse système après MOSFET dos-à-dos. R7 = 470 Ω / C4 = 100 nF / R8 = 2 kΩ : valeurs typ. datasheet S-8261. Q1 : RDS(on) < 2 × 20 mΩ à VGS 3,6 V ⇒ 4 mW perdus à 300 mA. C34 au plus près du connecteur cellule.
C · Buck-boost 3,3 V (TPS63900, IQ 75 nA) et rail RF filtré
SEL = 0 ⇒ VO(1) fixé par CFG3 : R11 = 16,2 k ⇒ 3,3 V. CFG1/CFG2 : R9 = 36,5 k, R10 = 0 Ω ⇒ VO(2) = 3,3 V, limite d'entrée « unlimited » (pics TX +22 dBm). Résistances 1 %, ≤ 200 ppm/°C (lues une seule fois au démarrage). L1 DFE252012F-2R2M (2520) : ISAT 3,3 A ≥ 2 A exigés en « unlimited », Itemp 2,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
Rail +3V3_RF (VDDPA, VDDRF, front-end)
FB3 : 220 Ω @ 100 MHz, RDC ≤ 0,1 Ω, 1,4 A — chute < 15 mV à 120 mA (TX +22 dBm).
D · Récupération d'énergie piézoélectrique (LTC3588-1 + supercondensateurs)
Surveillance VPZ / PGOOD
Pont 10 M / 10 M : 0,18 µA ; C40 fournit la charge d'échantillonnage de l'ADC.
D2 : TVS bidirectionnelle 24 V à l'entrée (chocs, ESD câble). R12/R13 1 kΩ anti-surge : limitent le courant dans le shunt 20 V interne du LTC3588 sans pénaliser la récupération (chute < 0,1 V à 100 µA). D1 = D0 = VIN2 → VOUT = 3,6 V. 2 supercondensateurs 2,7 V en série (1,8 V chacun). Équilibrage U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
E · OR-ing des sources (2 × LM66100, RCB)
U6 (VPZ) et U11 (VSYS) en OR-ing vers VIN_BB : la source la plus haute alimente le buck-boost. CE relié à VOUT = blocage permanent du courant inverse (RCB, datasheet §8.3.2). Rév. B : CE à GND ⇒ interrupteur toujours passant, la batterie se vidait dans les supercaps. Le piézo ne charge plus jamais 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
F · Notes de conception
Généralités
1. Rév. C : brochages vérifiés sur datasheets (DS13105, SLVSET3D, SLUS810N, UBX-20035208, LTC3588, MAX17048, XA17-G4K). Empreintes projet : keeptracker.pretty. 2. LoRaWAN EU868 (863–870 MHz) : vérifier la bande applicable au Maroc (ANRT). 3. Réseau RF STM32WL (MN1) : reprendre la référence ST (AN54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
Filtrage, découplage et robustesse (rév. B)
• Condensateurs : tension nominale ≥ 2 × tension de service ; X7R ≤ 100 nF, X5R au-delà, C0G pour 47 pF / 6,8 pF. Prévoir −50 % (polarisation DC) sur 10–22 µF. • Découplage : 1 × 100 nF par broche d'alimentation à < 2 mm, via direct vers GND ; réservoir 4,7–10 µF par rail ; 47 pF C0G (résonance ≈ 8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
G · Microcontrôleur STM32WLE5 et radio LoRa 868 MHz
Découplage VDD (11, 44) · VBAT (37) · VDDSMPS · VDDA · SMPS 1,55 V : VFBSMPS = VDDRF1V55, Cout = 470 nF (DS13105)
TCXO → 220 Ω + 10 pF → OSC_IN : amplitude ramenée à 0,4–0,5 Vpp (limite l'injection de raies parasites dans la radio).
Découplage RF (+3V3_RF) — VDDPA : 4,7 µF + 100 nF + 47 pF · VDDRF : 100 nF + 47 pF
Front-end RF 868 MHz : PA HP (+22 dBm) → filtre passe-bas / piège H2 → switch SPDT → 50 Ω
Accord antenne (Abracon : 0 Ω + 3,0 pF)
Table switch : TX ⇒ FE_CTRL1 = 0, FE_CTRL2 = 1 · RX ⇒ FE_CTRL1 = 1, FE_CTRL2 = 0 · veille ⇒ 0 / 0. Selfs RF : bobinées 0402 Murata LQW15 (Q élevé, pertes mini) · condensateurs C0G ±0,25 pF. Réseau recopié de la carte Olimex BB-STM32WL rév. D1 (même MCU) : à reconfirmer au VNA sur notre PCB. D5 : ES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
H · GNSS u-blox MAX-M10S, interrupteur d'alimentation et filtrage
Réseau en Pi (NM / 0 Ω / NM) : accord de l'antenne sur carte
FB4 + C28/C48/C49 : isolent le GNSS du bruit numérique et de l'émission LoRa. R29–R31 (1 kΩ série) : limitent la rétro-alimentation quand GNSS_EN = 0. V_IO = VCC (VIO_SEL ouvert ⇒ E/S 3,3 V). V_BCKP alimenté par PA9 via R40 : 28 µA en backup matériel, 1er poste de consommation en veille ⇒ le firmwa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
I · Détection de mouvement (LIS2DW12)
C29 → VDD, C30 → VDD_IO, C53 réservoir (recommandation ST).
J · Programmation SWD
K · Points de test et fixations
L · Arbre d'alimentation, impédances contrôlées et pertes
USB-C 5 V → D1 TVS + F1 PTC + FB2 → BQ24074 (IN, OVP 10,5 V, ILIM 1,3 A, ITERM 60 mA) → VSYS Cellule Li-ion 1S → F2 3 A → S-8261 / AO8814 (OV · UV · OC · CC) → VBAT → BQ24074 (chemin d'alimentation) → VSYS Piézo → D2 TVS + R12/R13 → LTC3588-1 → VPZ 3,6 V (2 × 10 F, U12 ALD910025) → U6 LM66100 → VIN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
Impédance contrôlée (classe RF_50R)
Empilage JLC04161H-7628 (1,6 mm) : L1 SIG/RF · L2 GND plein · L3 PWR · L4 SIG — diélectrique L1→L2 = 0,21 mm, εr 4,4. CPWG 50 Ω (L1, référence L2) : piste 0,26 mm, fente 0,20 mm, εeff ≈ 3,05 (calcul Wadell, à reconfirmer sur le calculateur du fabricant). Nets 50 Ω : LORA_RF, LORA_ANT, GNSS_ANT, GNS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
Pertes maîtrisées (rév. C)
TPS63900 IQ 75 nA · LM66100 IQ 150 nA, RON 79 mΩ · TPS22916 coupe le GNSS · ALD910025 : 0 A d'équilibrage à 1,8 V/cellule. Pull-ups côté batterie 100 kΩ (ALRT, PG, CHG) · pont VPZ 2 × 10 MΩ (0,18 µA) · V_BCKP GNSS (28 µA) commuté par PA9. Chemin de puissance : FB2 25 mΩ, F2 + Q1 ≈ 50 mΩ, L1 ISAT ≥ 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
