bachirstudies-lang/Keep_Tracking/shema electrique/rev_B/keeptracker.kicad_sch

## KiCad design shema electrique/rev_B/keeptracker.kicad_sch (2026-10-11)

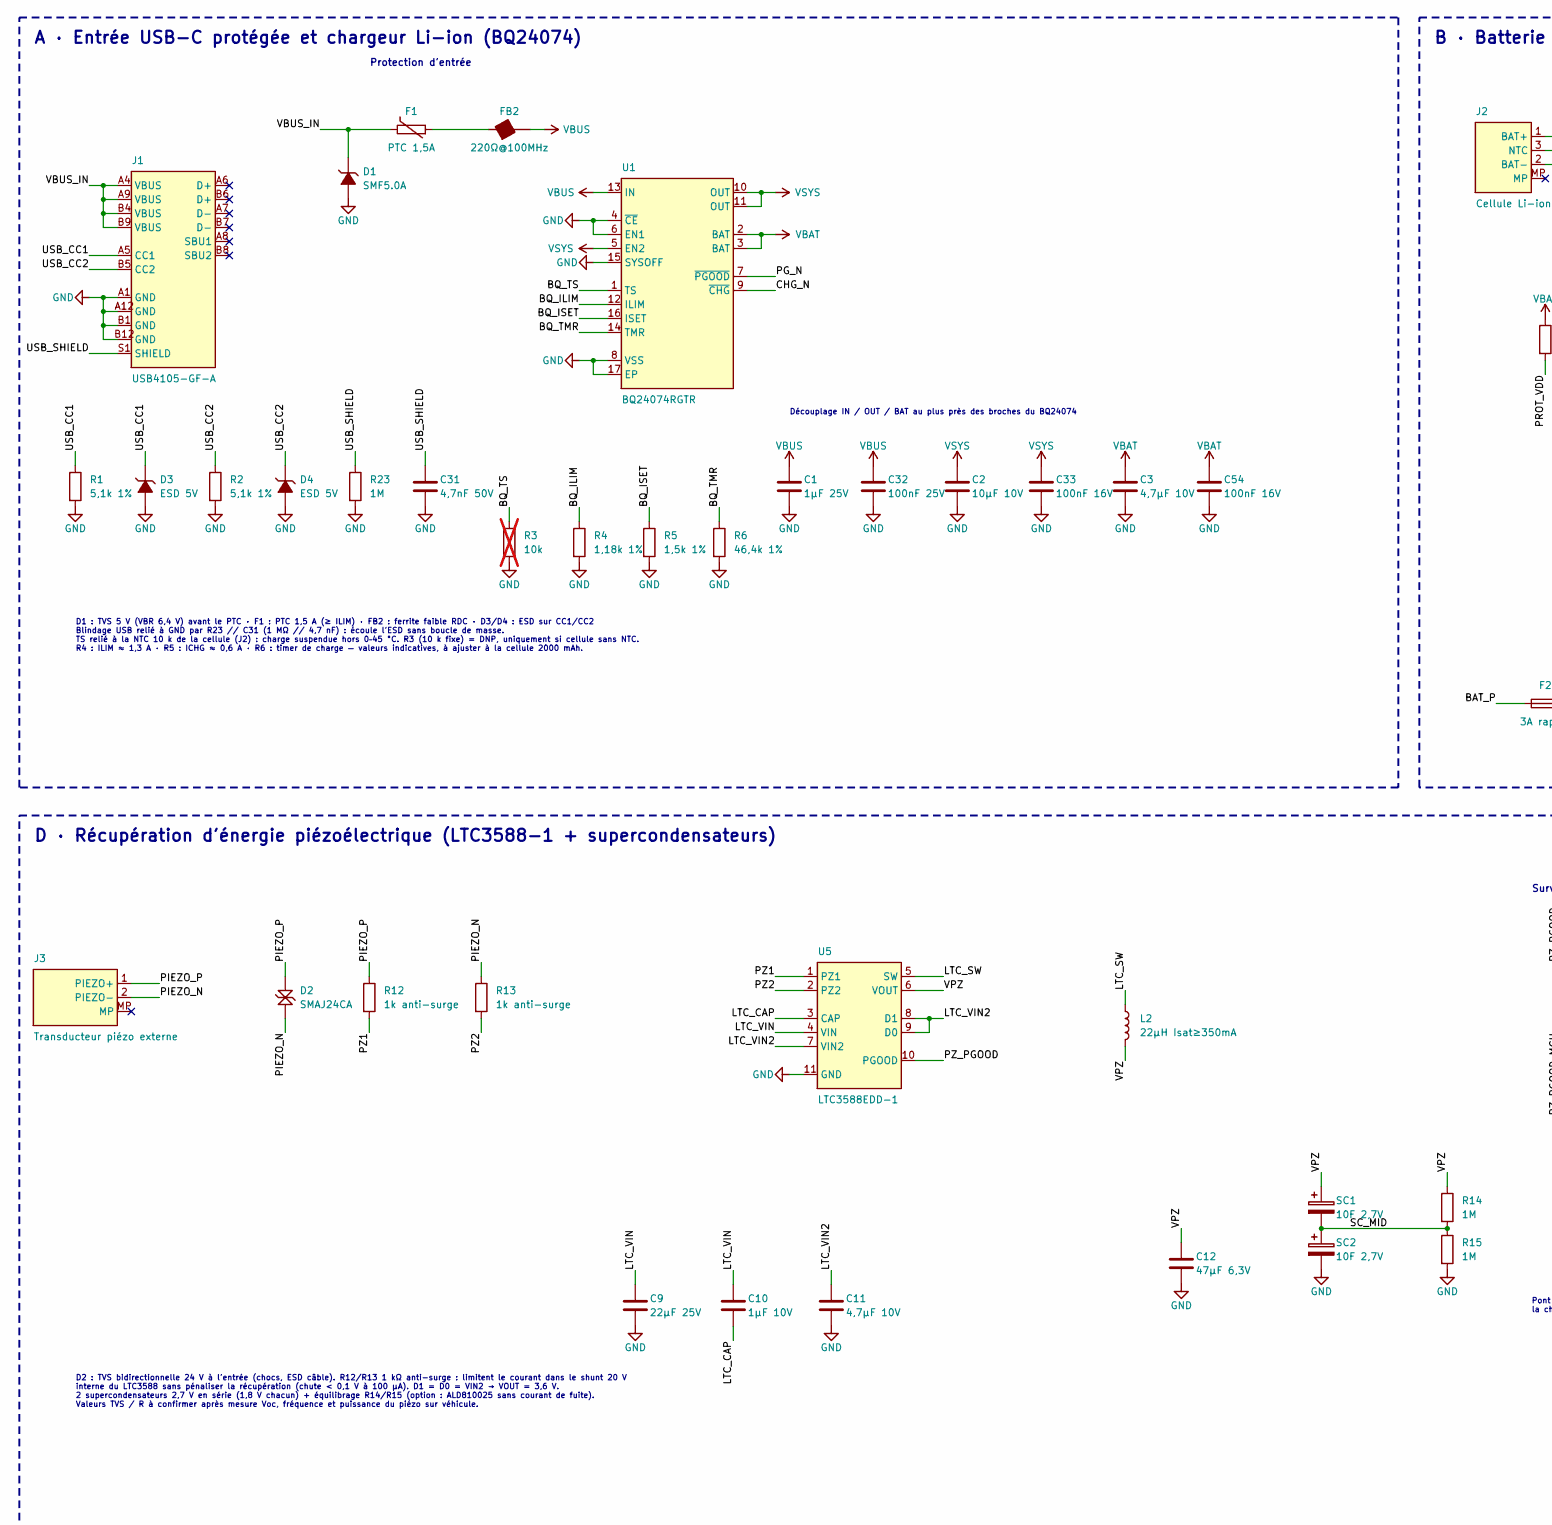
[picture p23: schematic keeptracker.kicad_sch, part in row 1, column 1]

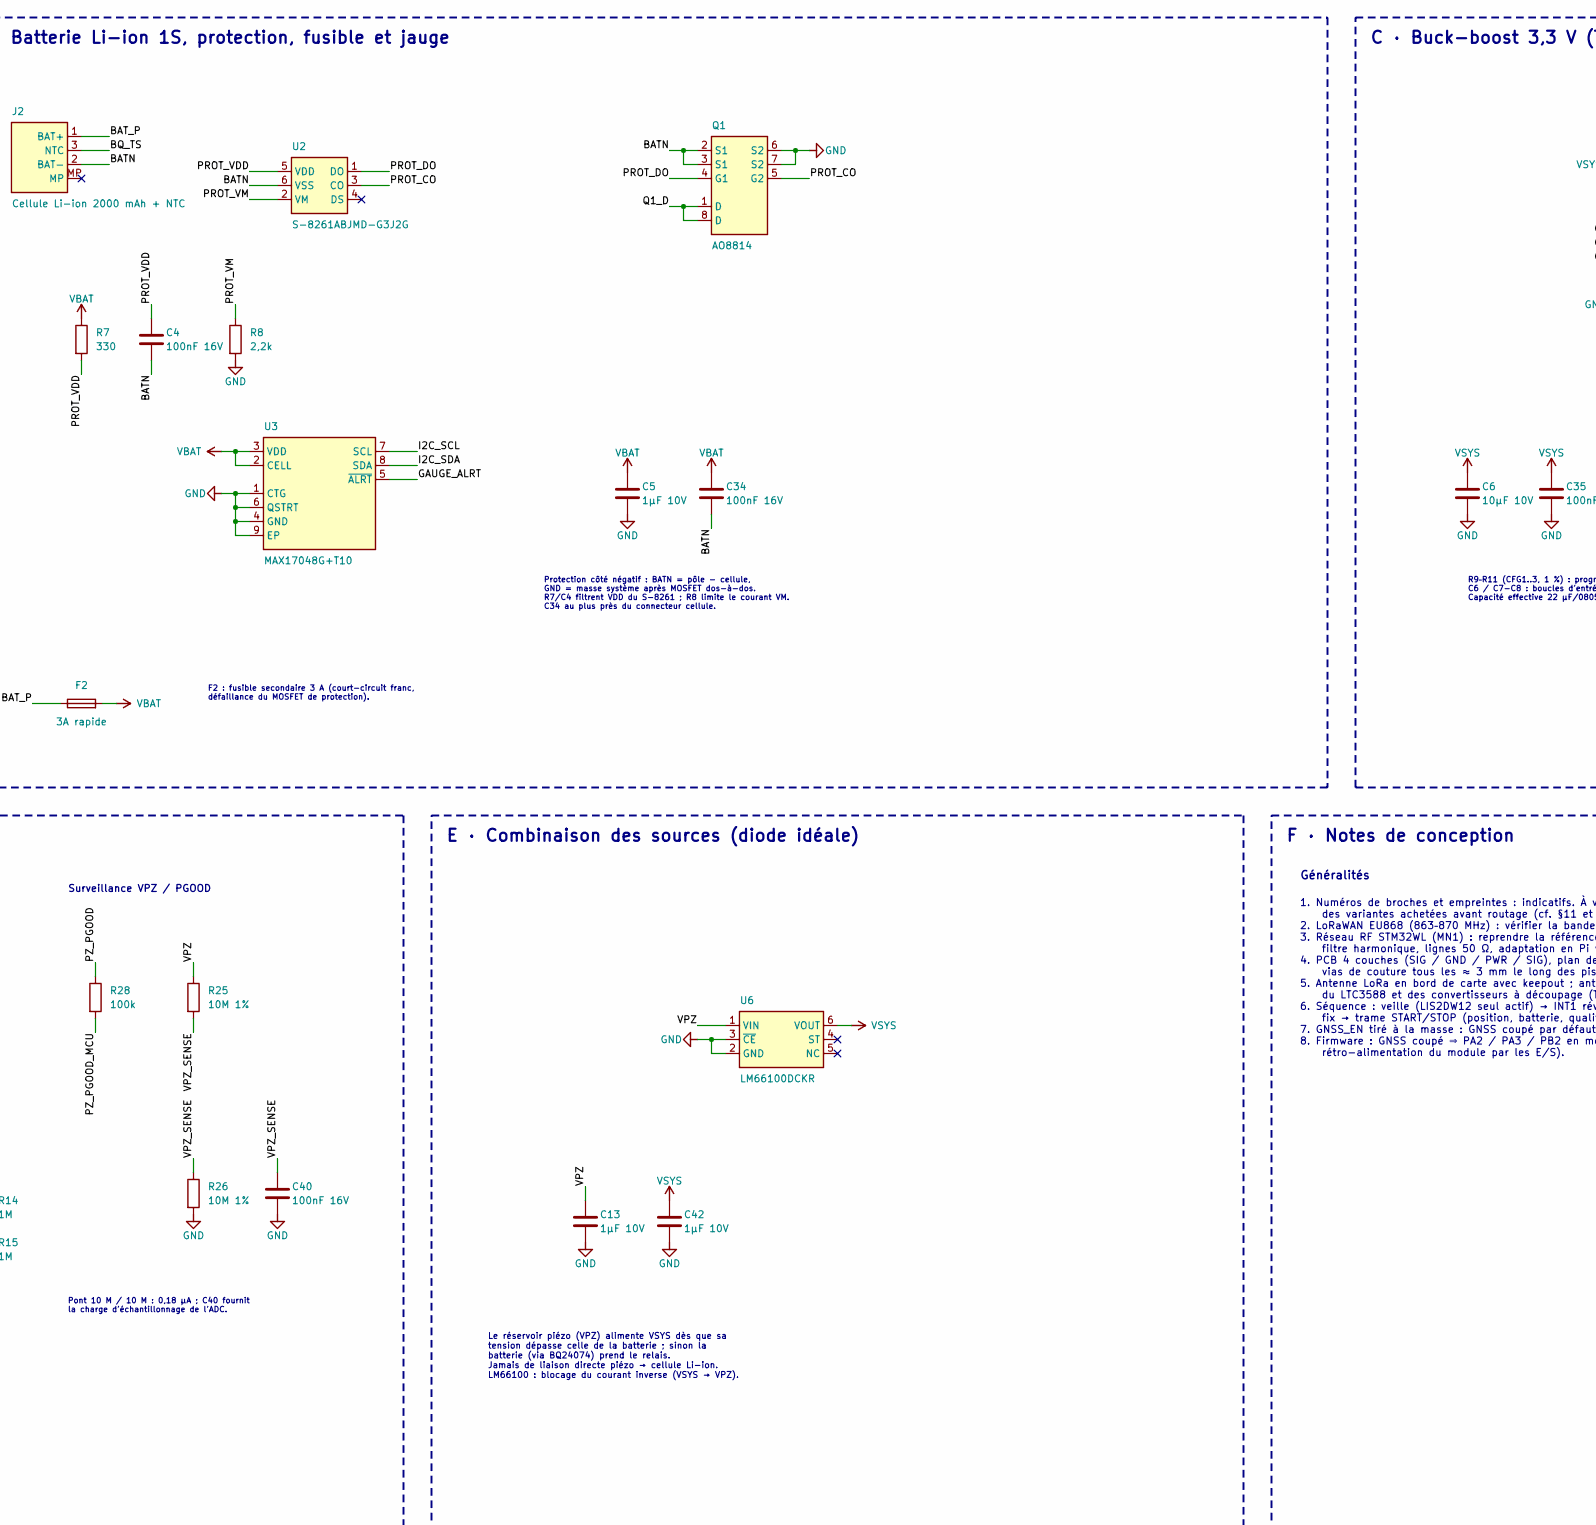
[picture p24: schematic keeptracker.kicad_sch, part in row 1, column 2]

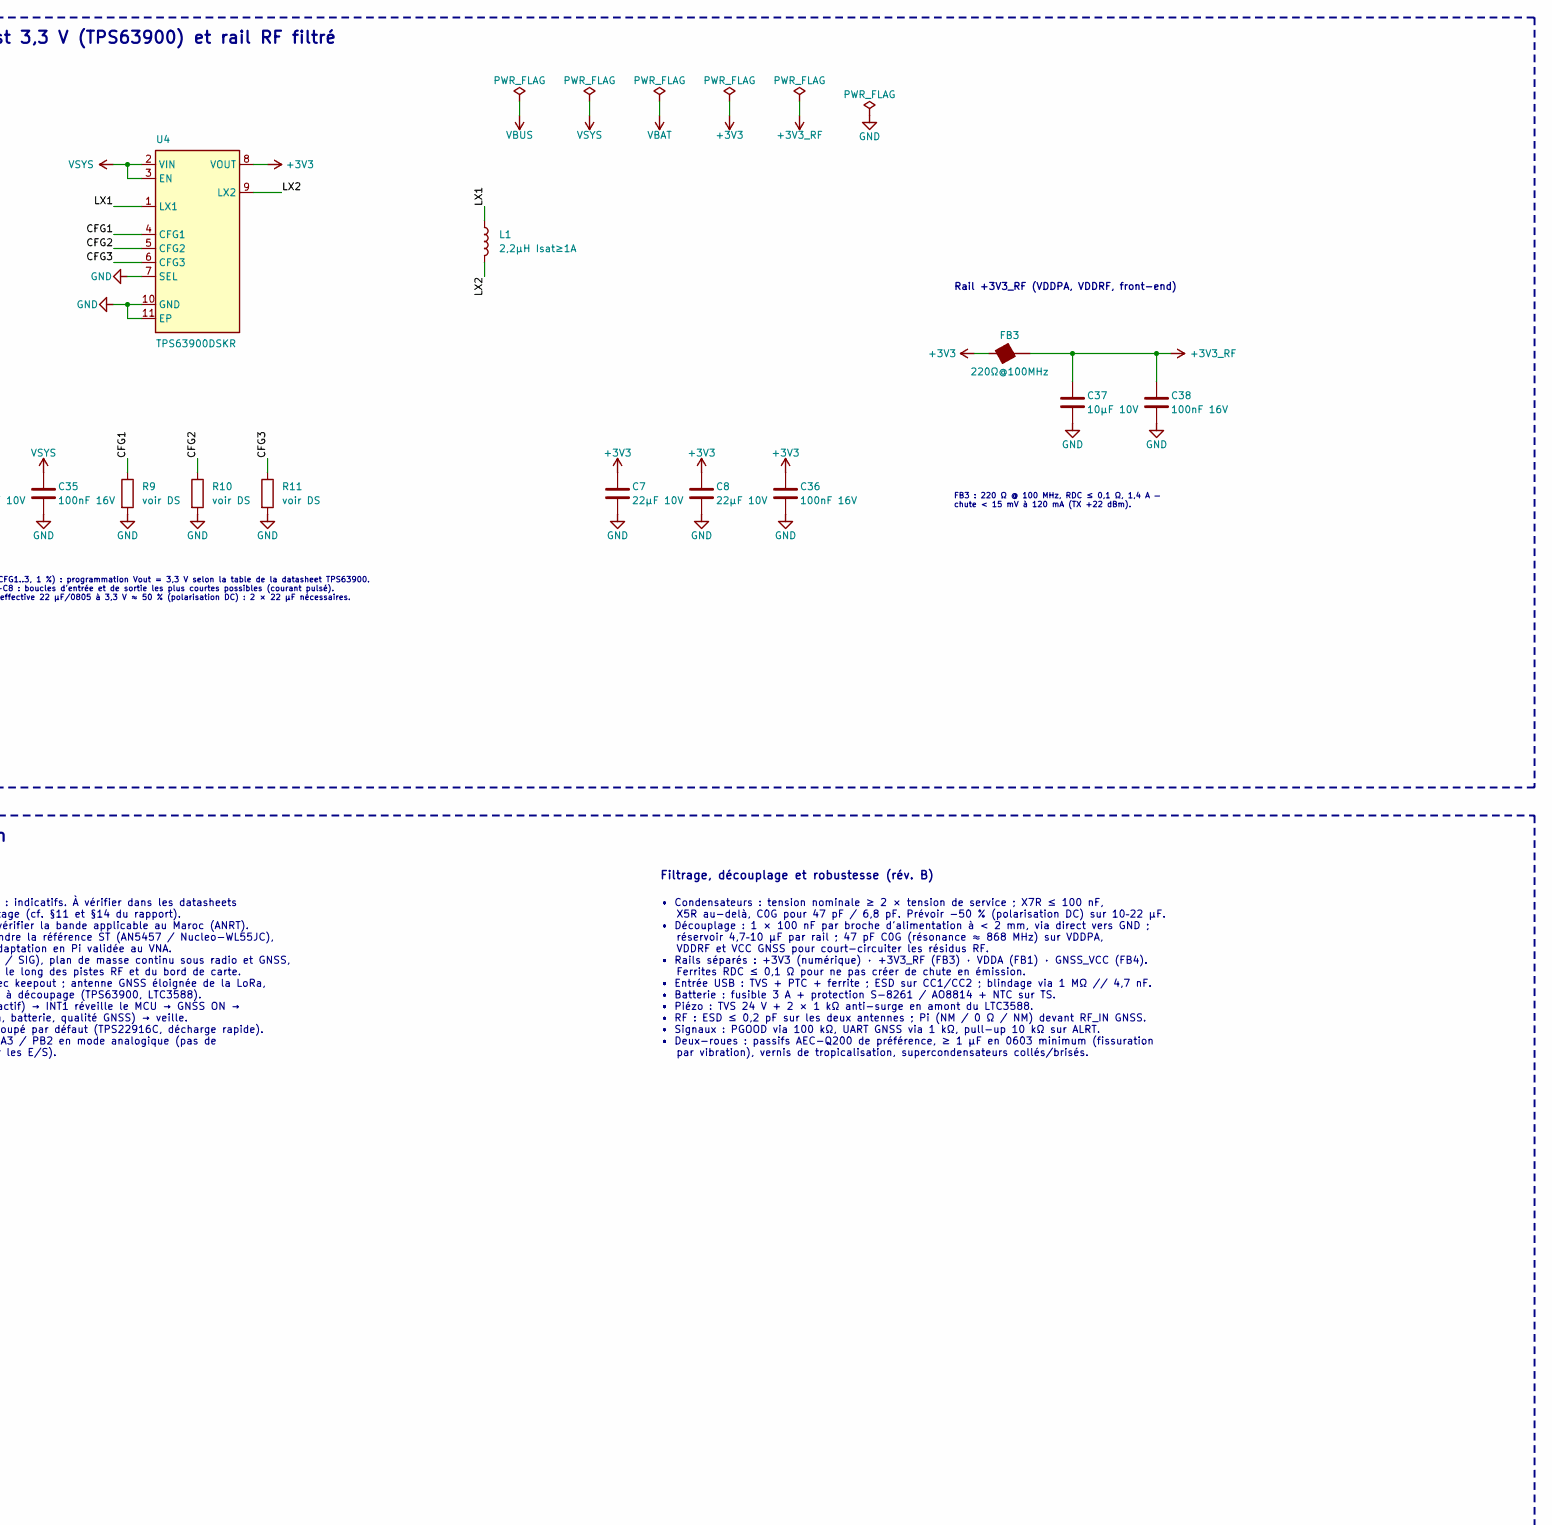
[picture p25: schematic keeptracker.kicad_sch, part in row 1, column 3]

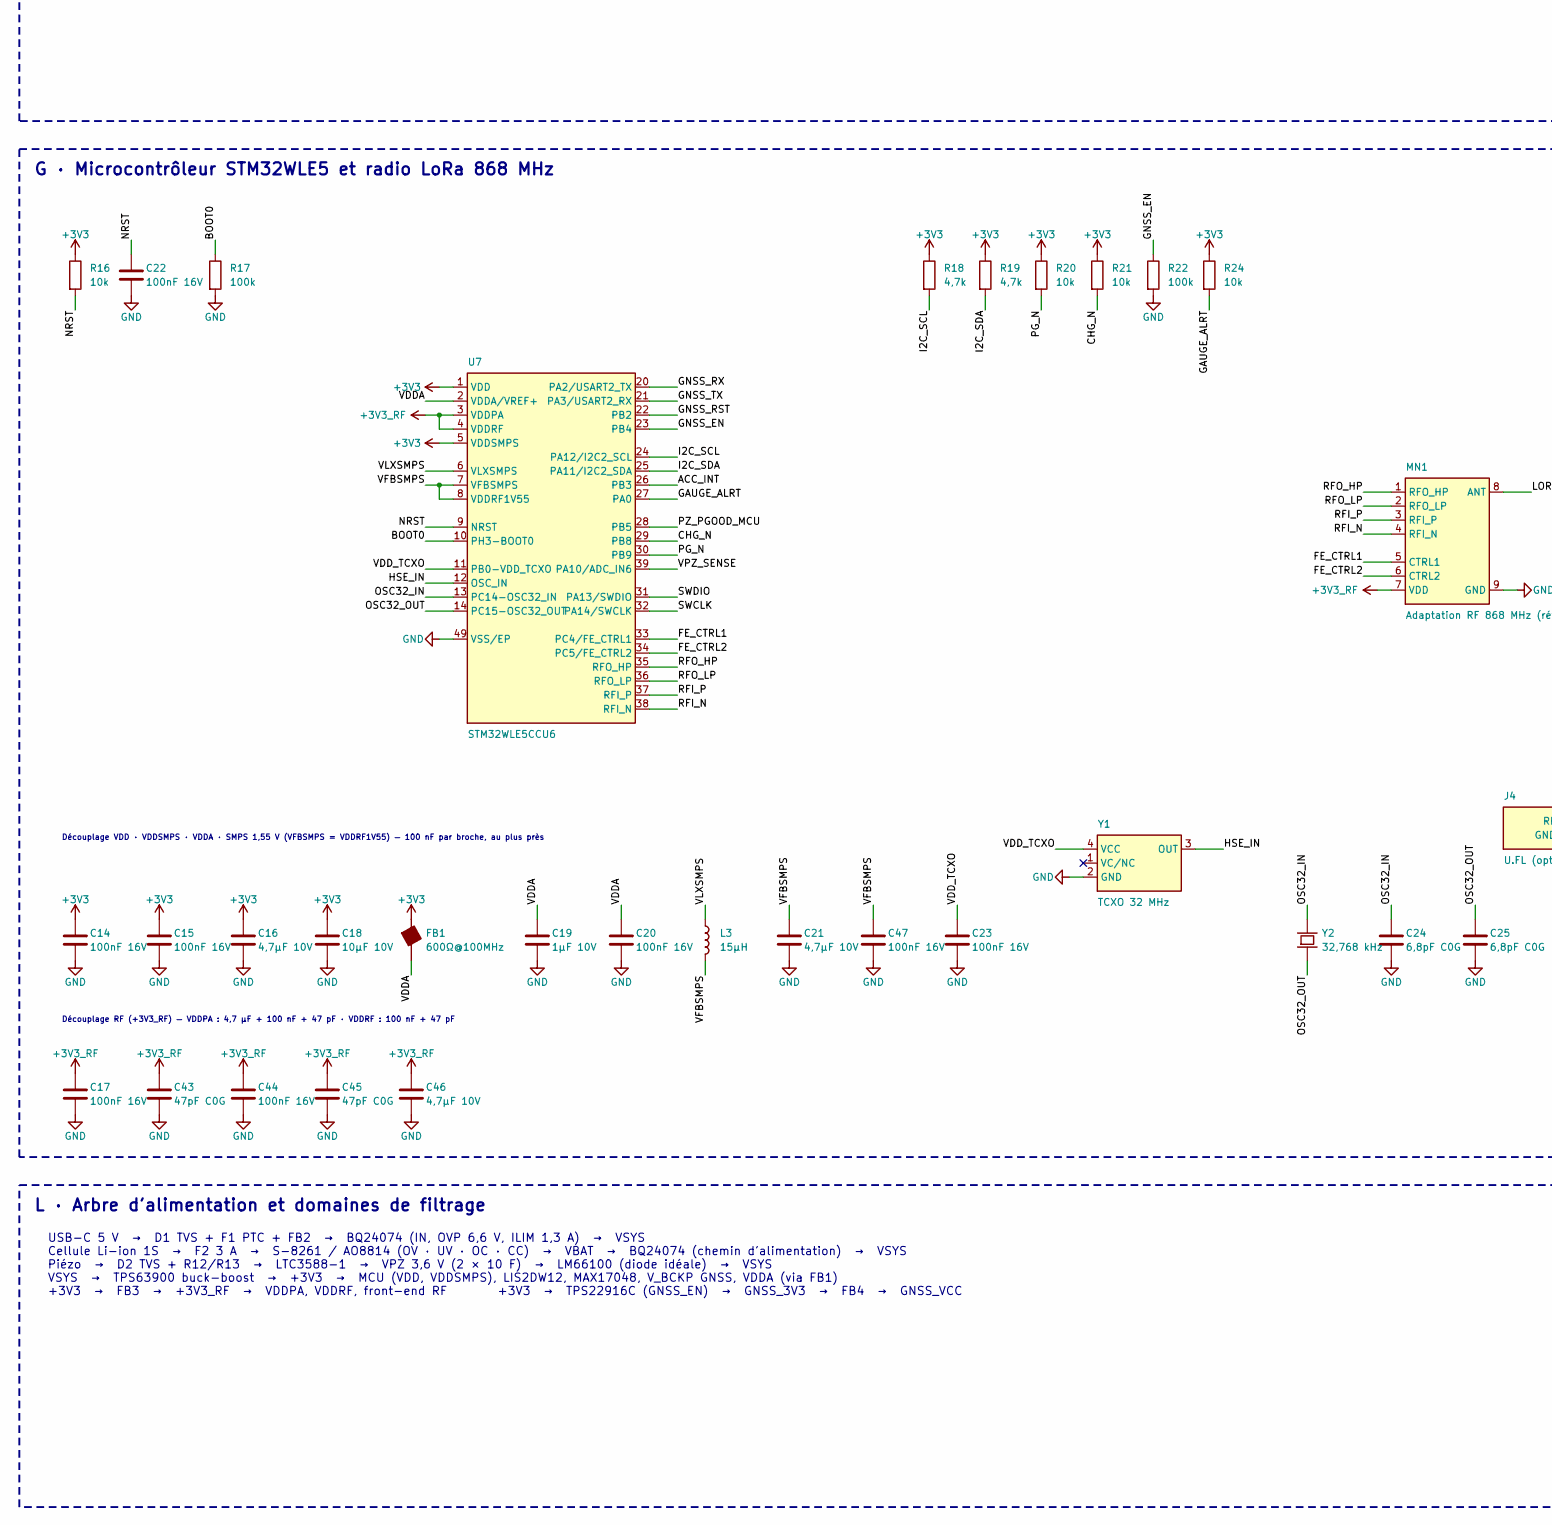
[picture p26: schematic keeptracker.kicad_sch, part in row 2, column 1]

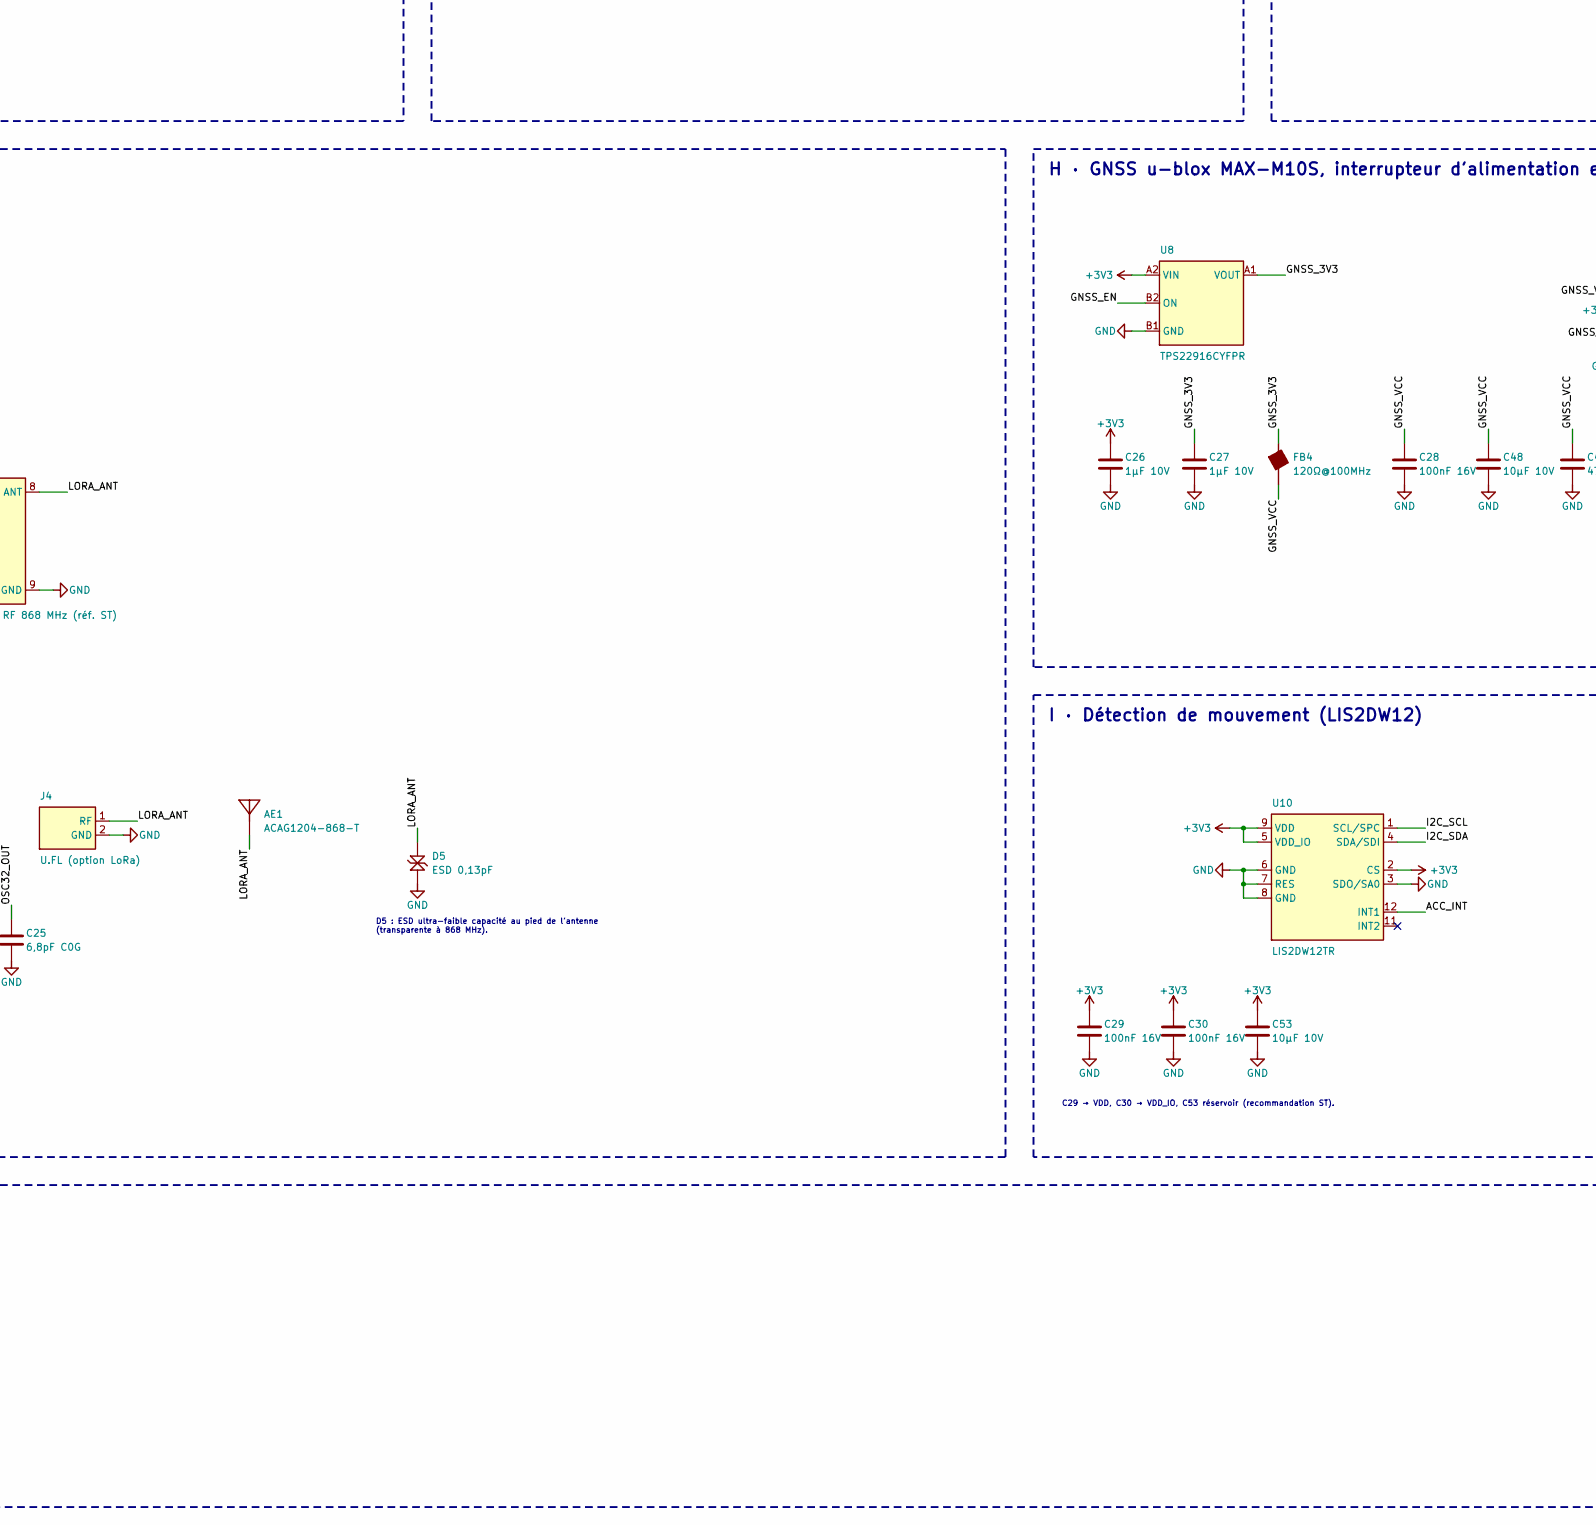
[picture p27: schematic keeptracker.kicad_sch, part in row 2, column 2]

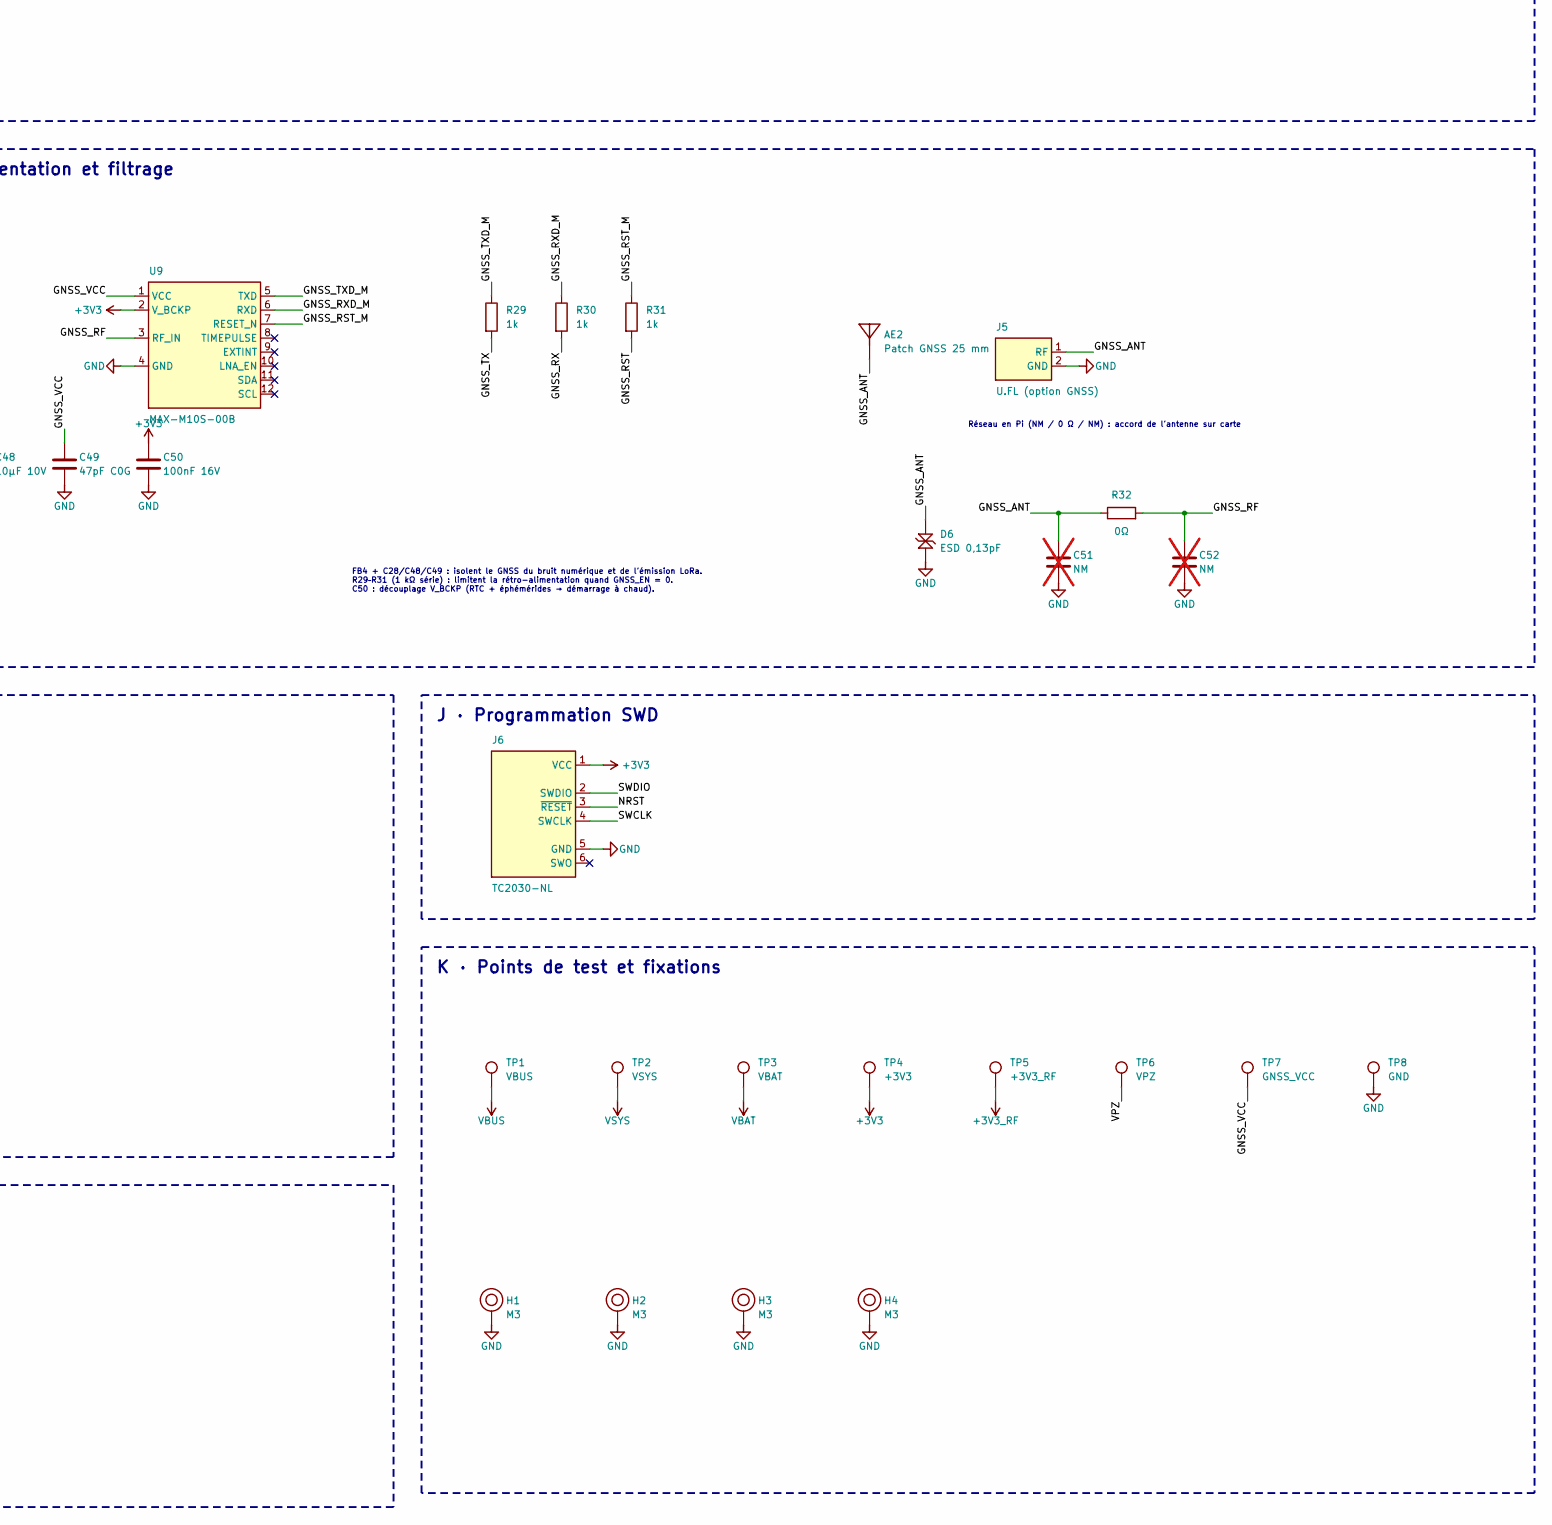
[picture p28: schematic keeptracker.kicad_sch, part in row 2, column 3]

Parts:
AE1: ACAG1204-868-T
AE2: Patch GNSS 25 mm
C1: 1µF 25V; C_0603_1608Metric
C2, C6, C18, C37, C48, C53: 10µF 10V; C_0805_2012Metric
C3, C11, C16, C21, C46: 4,7µF 10V; C_0603_1608Metric
C4, C14, C15, C17, C20, C22, C23, C28, C29, C30, C33, C34, C35, C36, C38, C40, C44, C47, C50, C54: 100nF 16V; C_0402_1005Metric
C5, C13, C19, C26, C27, C42: 1µF 10V; C_0402_1005Metric
C7, C8: 22µF 10V; C_0805_2012Metric
C9: 22µF 25V; C_1206_3216Metric
C10: 1µF 10V; C_0603_1608Metric
C12: 47µF 6,3V; C_1206_3216Metric
C24, C25: 6,8pF C0G; C_0402_1005Metric
C31: 4,7nF 50V; C_0402_1005Metric
C32: 100nF 25V; C_0402_1005Metric
C43, C45, C49: 47pF C0G; C_0402_1005Metric
C51, C52: NM; not fitted
D1: SMF5.0A; D_SOD-123F; MPN Littelfuse SMF5.0A
D2: SMAJ24CA; D_SMA; MPN Littelfuse SMAJ24CA
D3, D4: ESD 5V; D_SOD-923; MPN onsemi ESD9B5.0ST5G
D5, D6: ESD 0,13pF; D_0402_1005Metric; MPN TI TPD1E0B04DPLR
F1: PTC 1,5A; Fuse_1206_3216Metric; MPN Bourns MF-MSMF150-2
F2: 3A rapide; Fuse_0603_1608Metric; MPN Littelfuse 0467003.NR
FB1: 600Ω@100MHz; L_0603_1608Metric; MPN Murata BLM18KG601SN1D
FB2, FB3: 220Ω@100MHz; L_0603_1608Metric; MPN Murata BLM18PG221SN1D
FB4: 120Ω@100MHz; L_0402_1005Metric; MPN Murata BLM15PX121SN1D
H1, H2, H3, H4: M3; MountingHole_3.2mm_M3_Pad_Via
J1: USB4105-GF-A; USB_C_Receptacle_GCT_USB4105-xx-A_16P_TopMnt_Horizontal; MPN GCT USB4105-GF-A
J2: Cellule Li-ion 2000 mAh + NTC; JST_PH_S3B-PH-SM4-TB_1x03-1MP_P2.00mm_Horizontal; MPN JST S3B-PH-SM4-TB
J3: Transducteur piézo externe; JST_ZH_B2B-ZR-SM4-TF_1x02-1MP_P1.50mm_Vertical; MPN JST B2B-ZR-SM4-TF
J4: U.FL (option LoRa); U.FL_Hirose_U.FL-R-SMT-1_Vertical
J5: U.FL (option GNSS); U.FL_Hirose_U.FL-R-SMT-1_Vertical
J6: TC2030-NL; Tag-Connect_TC2030-IDC-NL_2x03_P1.27mm_Vertical
L1: 2,2µH Isat≥1A; L_1210_3225Metric; MPN Murata DFE252012F-2R2M
L2: 22µH Isat≥350mA; L_1210_3225Metric; MPN Murata LQH32PH220MN0
L3: 15µH; L_0805_2012Metric; MPN Murata LQM21PN150MC0
MN1: Adaptation RF 868 MHz (réf. ST)
Q1: AO8814; TSSOP-8_4.4x3mm_P0.65mm; MPN AOS AO8814
R1, R2: 5,1k 1%; R_0603_1608Metric
R3: 10k; R_0603_1608Metric; not fitted
R4: 1,18k 1%; R_0603_1608Metric
R5: 1,5k 1%; R_0603_1608Metric
R6: 46,4k 1%; R_0603_1608Metric
R7: 330; R_0603_1608Metric
R8: 2,2k; R_0603_1608Metric
R9, R10, R11: voir DS; R_0402_1005Metric
R12, R13: 1k anti-surge; R_1206_3216Metric; MPN Panasonic ERJ-P08J102V
R14, R15, R23: 1M; R_0603_1608Metric
R16, R20, R21, R24: 10k; R_0603_1608Metric
R17, R22, R28: 100k; R_0603_1608Metric
R18, R19: 4,7k; R_0603_1608Metric
R25, R26: 10M 1%; R_0603_1608Metric
R29, R30, R31: 1k; R_0402_1005Metric
R32: 0Ω; R_0402_1005Metric
SC1, SC2: 10F 2,7V; CP_Radial_D8.0mm_P3.50mm; MPN Eaton HV0830-2R7106-R
TP1: VBUS; TestPoint_Pad_D1.5mm
TP2: VSYS; TestPoint_Pad_D1.5mm
TP3: VBAT; TestPoint_Pad_D1.5mm
TP4: +3V3; TestPoint_Pad_D1.5mm
TP5: +3V3_RF; TestPoint_Pad_D1.5mm
TP6: VPZ; TestPoint_Pad_D1.5mm
TP7: GNSS_VCC; TestPoint_Pad_D1.5mm
TP8: GND; TestPoint_Pad_D1.5mm
U1: BQ24074RGTR; VQFN-16-1EP_3x3mm_P0.5mm_EP1.68x1.68mm; MPN TI BQ24074RGTR
U2: S-8261ABJMD-G3J2G; SOT-23-6; MPN ABLIC S-8261ABJMD-G3J2G
U3: MAX17048G+T10; TDFN-8-1EP_2x2mm_P0.5mm_EP0.8x1.2mm; MPN Maxim MAX17048G+T10
U4: TPS63900DSKR; WSON-10-1EP_2.5x2.5mm_P0.5mm_EP1.2x2mm; MPN TI TPS63900DSKR
U5: LTC3588EDD-1; DFN-10-1EP_3x3mm_P0.5mm_EP1.65x2.38mm; MPN ADI LTC3588EDD-1
U6: LM66100DCKR; SOT-363_SC-70-6; MPN TI LM66100DCKR
U7: STM32WLE5CCU6; QFN-48-1EP_7x7mm_P0.5mm_EP5.3x5.3mm; MPN ST STM32WLE5CCU6
U8: TPS22916CYFPR; MPN TI TPS22916CYFPR
U9: MAX-M10S-00B; ublox_MAX; MPN u-blox MAX-M10S-00B
U10: LIS2DW12TR; LGA-12_2x2mm_P0.5mm; MPN ST LIS2DW12TR
Y1: TCXO 32 MHz; Oscillator_SMD_SiT_PQFN-4Pin_2.0x1.6mm
Y2: 32,768 kHz; Crystal_SMD_3215-2Pin_3.2x1.5mm

Connections:
+3V3: C7.1, C8.1, C14.1, C15.1, C16.1, C18.1, C26.1, C29.1, C30.1, C36.1, C50.1, C53.1, FB1.1, FB3.1, J6.1 (VCC), R16.1, R18.1, R19.1, R20.1, R21.1, R24.1, TP4.1, U4.8 (VOUT), U7.1 (VDD), U7.5 (VDDSMPS), U8.A2 (VIN), U9.2 (V_BCKP), U10.2 (CS), U10.5 (VDD_IO), U10.9 (VDD)
+3V3_RF: C17.1, C37.1, C38.1, C43.1, C44.1, C45.1, C46.1, FB3.2, MN1.7 (VDD), TP5.1, U7.3 (VDDPA), U7.4 (VDDRF)
ACC_INT: U7.26 (PB3), U10.12 (INT1)
BATN: C4.2, C34.2, J2.2 (BAT-), Q1.2 (S1), Q1.3 (S1), U2.6 (VSS)
BAT_P: F2.1, J2.1 (BAT+)
BOOT0: R17.1, U7.10 (PH3-BOOT0)
BQ_ILIM: R4.1, U1.12 (ILIM)
BQ_ISET: R5.1, U1.16 (ISET)
BQ_TMR: R6.1, U1.14 (TMR)
BQ_TS: J2.3 (NTC), R3.1, U1.1 (TS)
CFG1: R9.1, U4.4 (CFG1)
CFG2: R10.1, U4.5 (CFG2)
CFG3: R11.1, U4.6 (CFG3)
CHG_N: R21.2, U1.9 (~CHG), U7.29 (PB8)
FE_CTRL1: MN1.5 (CTRL1), U7.33 (PC4/FE_CTRL1)
FE_CTRL2: MN1.6 (CTRL2), U7.34 (PC5/FE_CTRL2)
GAUGE_ALRT: R24.2, U3.5 (~ALRT), U7.27 (PA0)
GND: C1.2, C2.2, C3.2, C5.2, C6.2, C7.2, C8.2, C9.2, C11.2, C12.2, C13.2, C14.2, C15.2, C16.2, C17.2, C18.2, C19.2, C20.2, C21.2, C22.2, C23.2, C24.2, C25.2, C26.2, C27.2, C28.2, C29.2, C30.2, C31.2, C32.2, C33.2, C35.2, C36.2, C37.2, C38.2, C40.2, C42.2, C43.2, C44.2, C45.2, C46.2, C47.2, C48.2, C49.2, C50.2, C51.2, C52.2, C53.2, C54.2, D1.2, D3.2, D4.2, D5.2, D6.2, H1.1, H2.1, H3.1, H4.1, J1.A1 (GND), J1.A12 (GND), J1.B1 (GND), J1.B12 (GND), J4.2 (GND), J5.2 (GND), J6.5 (GND), MN1.9 (GND), Q1.6 (S2), Q1.7 (S2), R1.2, R2.2, R3.2, R4.2, R5.2, R6.2, R8.2, R9.2, R10.2, R11.2, R15.2, R17.2, R22.2, R23.2, R26.2, SC2.2, TP8.1, U1.4 (~CE), U1.6 (EN1), U1.8 (VSS), U1.15 (SYSOFF), U1.17 (EP), U3.1 (CTG), U3.4 (GND), U3.6 (QSTRT), U3.9 (EP), U4.7 (SEL), U4.10 (GND), U4.11 (EP), U5.11 (GND), U6.2 (GND), U6.3 (~CE), U7.49 (VSS/EP), U8.B1 (GND), U9.4 (GND), U10.3 (SDO/SA0), U10.6 (GND), U10.7 (RES), U10.8 (GND), Y1.2 (GND)
GNSS_3V3: C27.1, FB4.1, U8.A1 (VOUT)
GNSS_ANT: AE2.1, C51.1, D6.1, J5.1 (RF), R32.1
GNSS_EN: R22.1, U7.23 (PB4), U8.B2 (ON)
GNSS_RF: C52.1, R32.2, U9.3 (RF_IN)
GNSS_RST: R31.2, U7.22 (PB2)
GNSS_RST_M: R31.1, U9.7 (RESET_N)
GNSS_RX: R30.2, U7.20 (PA2/USART2_TX)
GNSS_RXD_M: R30.1, U9.6 (RXD)
GNSS_TX: R29.2, U7.21 (PA3/USART2_RX)
GNSS_TXD_M: R29.1, U9.5 (TXD)
GNSS_VCC: C28.1, C48.1, C49.1, FB4.2, TP7.1, U9.1 (VCC)
HSE_IN: U7.12 (OSC_IN), Y1.3 (OUT)
I2C_SCL: R18.2, U3.7 (SCL), U7.24 (PA12/I2C2_SCL), U10.1 (SCL/SPC)
I2C_SDA: R19.2, U3.8 (SDA), U7.25 (PA11/I2C2_SDA), U10.4 (SDA/SDI)
LORA_ANT: AE1.1, D5.1, J4.1 (RF), MN1.8 (ANT)
LTC_CAP: C10.2, U5.3 (CAP)
LTC_SW: L2.1, U5.5 (SW)
LTC_VIN: C9.1, C10.1, U5.4 (VIN)
LTC_VIN2: C11.1, U5.7 (VIN2), U5.8 (D1), U5.9 (D0)
LX1: L1.1, U4.1 (LX1)
LX2: L1.2, U4.9 (LX2)
NRST: C22.1, J6.3 (~RESET), R16.2, U7.9 (NRST)
unnamed: F1.2, FB2.1
OSC32_IN: C24.1, U7.13 (PC14-OSC32_IN), Y2.1
OSC32_OUT: C25.1, U7.14 (PC15-OSC32_OUT), Y2.2
PG_N: R20.2, U1.7 (~PGOOD), U7.30 (PB9)
PIEZO_N: D2.2, J3.2 (PIEZO-), R13.1
PIEZO_P: D2.1, J3.1 (PIEZO+), R12.1
PROT_CO: Q1.5 (G2), U2.3 (CO)
PROT_DO: Q1.4 (G1), U2.1 (DO)
PROT_VDD: C4.1, R7.2, U2.5 (VDD)
PROT_VM: R8.1, U2.2 (VM)
PZ1: R12.2, U5.1 (PZ1)
PZ2: R13.2, U5.2 (PZ2)
PZ_PGOOD: R28.1, U5.10 (PGOOD)
PZ_PGOOD_MCU: R28.2, U7.28 (PB5)
Q1_D: Q1.1 (D), Q1.8 (D)
RFI_N: MN1.4 (RFI_N), U7.38 (RFI_N)
RFI_P: MN1.3 (RFI_P), U7.37 (RFI_P)
RFO_HP: MN1.1 (RFO_HP), U7.35 (RFO_HP)
RFO_LP: MN1.2 (RFO_LP), U7.36 (RFO_LP)
SC_MID: R14.2, R15.1, SC1.2, SC2.1
SWCLK: J6.4 (SWCLK), U7.32 (PA14/SWCLK)
SWDIO: J6.2 (SWDIO), U7.31 (PA13/SWDIO)
USB_CC1: D3.1, J1.A5 (CC1), R1.1
USB_CC2: D4.1, J1.B5 (CC2), R2.1
USB_SHIELD: C31.1, J1.S1 (SHIELD), R23.1
VBAT: C3.1, C5.1, C34.1, C54.1, F2.2, R7.1, TP3.1, U1.2 (BAT), U1.3 (BAT), U3.2 (CELL), U3.3 (VDD)
VBUS: C1.1, C32.1, FB2.2, TP1.1, U1.13 (IN)
VBUS_IN: D1.1, F1.1, J1.A4 (VBUS), J1.A9 (VBUS), J1.B4 (VBUS), J1.B9 (VBUS)
VDDA: C19.1, C20.1, FB1.2, U7.2 (VDDA/VREF+)
VDD_TCXO: C23.1, U7.11 (PB0-VDD_TCXO), Y1.4 (VCC)
VFBSMPS: C21.1, C47.1, L3.2, U7.7 (VFBSMPS), U7.8 (VDDRF1V55)
VLXSMPS: L3.1, U7.6 (VLXSMPS)
VPZ: C12.1, C13.1, L2.2, R14.1, R25.1, SC1.1, TP6.1, U5.6 (VOUT), U6.1 (VIN)
VPZ_SENSE: C40.1, R25.2, R26.1, U7.39 (PA10/ADC_IN6)
VSYS: C2.1, C6.1, C33.1, C35.1, C42.1, TP2.1, U1.5 (EN2), U1.10 (OUT), U1.11 (OUT), U4.2 (VIN), U4.3 (EN), U6.6 (VOUT)

Notes on the sheet:
A · Entrée USB-C protégée et chargeur Li-ion (BQ24074)
Protection d'entrée
Découplage IN / OUT / BAT au plus près des broches du BQ24074
D1 : TVS 5 V (VBR 6,4 V) avant le PTC · F1 : PTC 1,5 A (≥ ILIM) · FB2 : ferrite faible RDC · D3/D4 : ESD sur CC1/CC2 Blindage USB relié à GND par R23 // C31 (1 MΩ // 4,7 nF) : écoule l'ESD sans boucle de masse. TS relié à la NTC 10 k de la cellule (J2) : charge suspendue hors 0–45 °C. R3 (10 k fixe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
B · Batterie Li-ion 1S, protection, fusible et jauge
F2 : fusible secondaire 3 A (court-circuit franc, défaillance du MOSFET de protection).
Protection côté négatif : BATN = pôle − cellule, GND = masse système après MOSFET dos-à-dos. R7/C4 filtrent VDD du S-8261 ; R8 limite le courant VM. C34 au plus près du connecteur cellule.
C · Buck-boost 3,3 V (TPS63900) et rail RF filtré
R9–R11 (CFG1..3, 1 %) : programmation Vout = 3,3 V selon la table de la datasheet TPS63900. C6 / C7-C8 : boucles d'entrée et de sortie les plus courtes possibles (courant pulsé). Capacité effective 22 µF/0805 à 3,3 V ≈ 50 % (polarisation DC) : 2 × 22 µF nécessaires.
Rail +3V3_RF (VDDPA, VDDRF, front-end)
FB3 : 220 Ω @ 100 MHz, RDC ≤ 0,1 Ω, 1,4 A — chute < 15 mV à 120 mA (TX +22 dBm).
D · Récupération d'énergie piézoélectrique (LTC3588-1 + supercondensateurs)
Surveillance VPZ / PGOOD
Pont 10 M / 10 M : 0,18 µA ; C40 fournit la charge d'échantillonnage de l'ADC.
D2 : TVS bidirectionnelle 24 V à l'entrée (chocs, ESD câble). R12/R13 1 kΩ anti-surge : limitent le courant dans le shunt 20 V interne du LTC3588 sans pénaliser la récupération (chute < 0,1 V à 100 µA). D1 = D0 = VIN2 → VOUT = 3,6 V. 2 supercondensateurs 2,7 V en série (1,8 V chacun) + équilibrage 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
E · Combinaison des sources (diode idéale)
Le réservoir piézo (VPZ) alimente VSYS dès que sa tension dépasse celle de la batterie ; sinon la batterie (via BQ24074) prend le relais. Jamais de liaison directe piézo → cellule Li-ion. LM66100 : blocage du courant inverse (VSYS → VPZ).
F · Notes de conception
Généralités
1. Numéros de broches et empreintes : indicatifs. À vérifier dans les datasheets des variantes achetées avant routage (cf. §11 et §14 du rapport). 2. LoRaWAN EU868 (863–870 MHz) : vérifier la bande applicable au Maroc (ANRT). 3. Réseau RF STM32WL (MN1) : reprendre la référence ST (AN5457 / Nucleo-W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
Filtrage, découplage et robustesse (rév. B)
• Condensateurs : tension nominale ≥ 2 × tension de service ; X7R ≤ 100 nF, X5R au-delà, C0G pour 47 pF / 6,8 pF. Prévoir −50 % (polarisation DC) sur 10–22 µF. • Découplage : 1 × 100 nF par broche d'alimentation à < 2 mm, via direct vers GND ; réservoir 4,7–10 µF par rail ; 47 pF C0G (résonance ≈ 8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
G · Microcontrôleur STM32WLE5 et radio LoRa 868 MHz
Découplage VDD · VDDSMPS · VDDA · SMPS 1,55 V (VFBSMPS = VDDRF1V55) — 100 nF par broche, au plus près
Découplage RF (+3V3_RF) — VDDPA : 4,7 µF + 100 nF + 47 pF · VDDRF : 100 nF + 47 pF
D5 : ESD ultra-faible capacité au pied de l'antenne (transparente à 868 MHz).
H · GNSS u-blox MAX-M10S, interrupteur d'alimentation et filtrage
Réseau en Pi (NM / 0 Ω / NM) : accord de l'antenne sur carte
FB4 + C28/C48/C49 : isolent le GNSS du bruit numérique et de l'émission LoRa. R29–R31 (1 kΩ série) : limitent la rétro-alimentation quand GNSS_EN = 0. C50 : découplage V_BCKP (RTC + éphémérides → démarrage à chaud).
I · Détection de mouvement (LIS2DW12)
C29 → VDD, C30 → VDD_IO, C53 réservoir (recommandation ST).
J · Programmation SWD
K · Points de test et fixations
L · Arbre d'alimentation et domaines de filtrage
USB-C 5 V → D1 TVS + F1 PTC + FB2 → BQ24074 (IN, OVP 6,6 V, ILIM 1,3 A) → VSYS Cellule Li-ion 1S → F2 3 A → S-8261 / AO8814 (OV · UV · OC · CC) → VBAT → BQ24074 (chemin d'alimentation) → VSYS Piézo → D2 TVS + R12/R13 → LTC3588-1 → VPZ 3,6 V (2 × 10 F) → LM66100 (diode idéale) → VSYS VSYS → TPS63900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
