bachirstudies-lang/Keep_Tracking/(commit log)

2026-10-11 Ajout du schéma électrique KiCad rév. C (dossier shema electrique)
    Projet KiCad 9 du traceur Keep Tracking : schéma, bibliothèques et
    empreintes projet, BOM, netlist, rapport ERC (0 erreur), PDF/PNG,
    script générateur et archives des révisions A et B.
    Rév. C : brochages vérifiés sur datasheets, ITERM BQ24074, OR-ing des
    sources (LM66100 en RCB), pertes réduites, lignes RF 50 ohms et
    front-end LoRa discret.
    [keeptracker.kicad_sch, keeptracker_bom.csv]
2026-10-12 Create Page de garde pour la documentation
    Voici la page de garde a respecter vous trouver les images gncc et insa sur whatssap
